FordPrfkt/KT88-Amp/boards/Bias/Bias.png

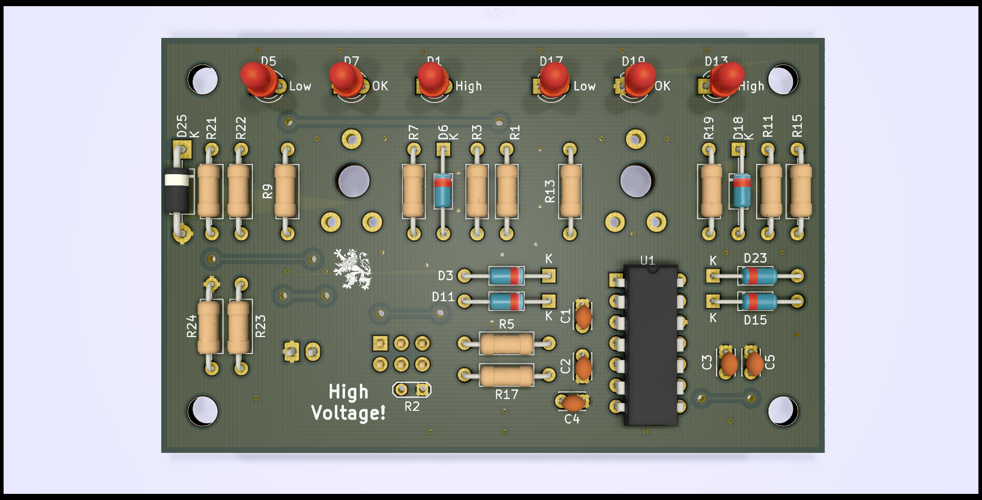
boards/Bias/Bias.png
