FordPrfkt/KT88-Amp/boards/Netzteil/400V_Anoden/400VAnoden.png

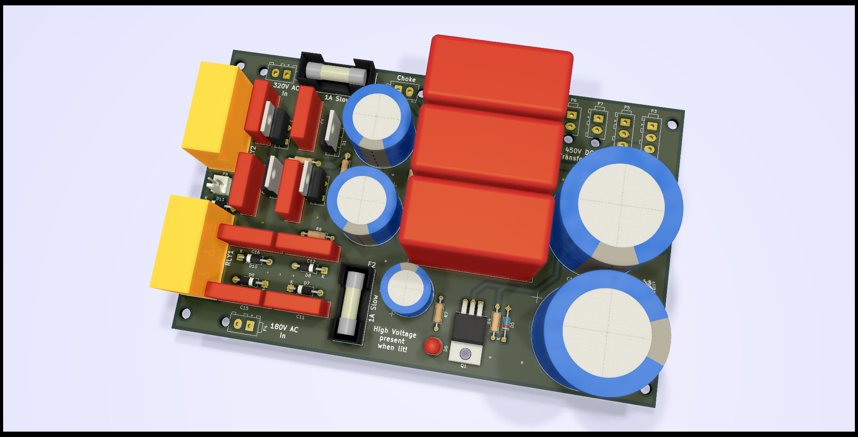
boards/Netzteil/400V_Anoden/400VAnoden.png
