FordPrfkt/KT88-Amp/README.md

# KT88-Amp
Tube Amplifier using KT88 Tubes
