FordPrfkt/KT88-Amp/boards/Endstufe/Endstufe.png

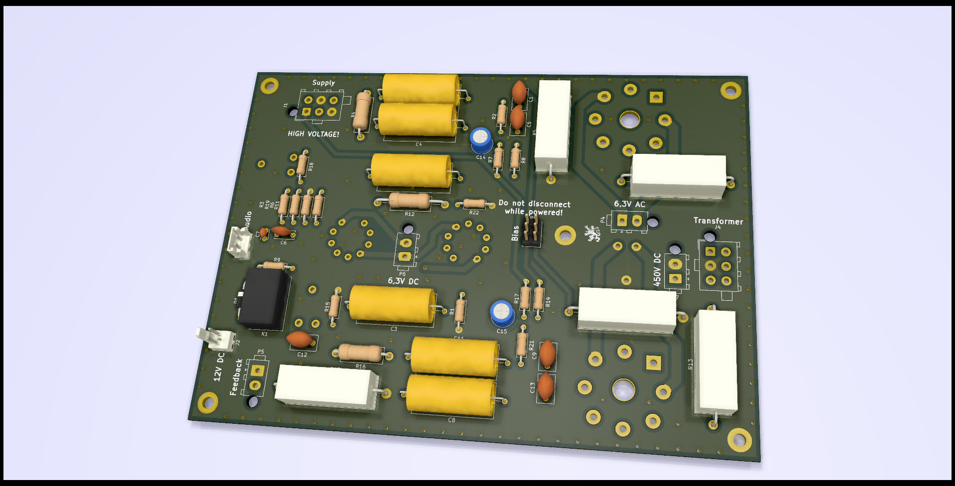
boards/Endstufe/Endstufe.png
