FordPrfkt/KT88-Amp/boards/Netzteil/Anoden_Stabi/Anoden_Stabi.png

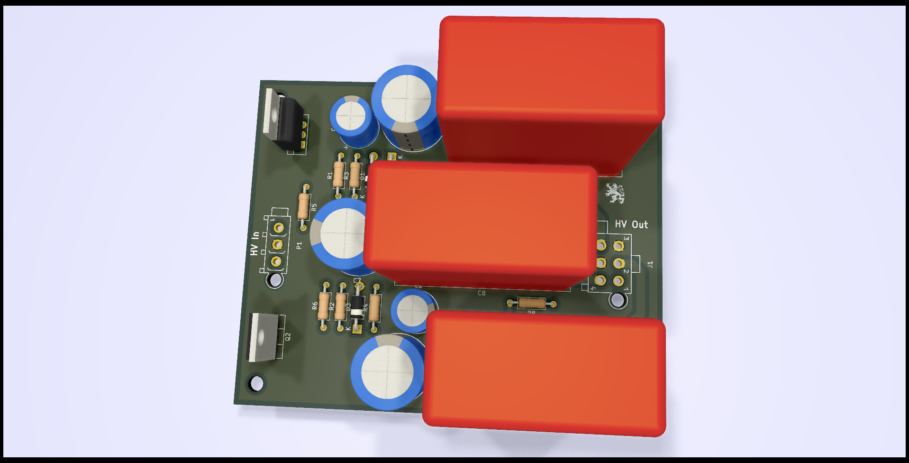
boards/Netzteil/Anoden_Stabi/Anoden_Stabi.png
