FordPrfkt/KT88-Amp/Boards/ReglerV2/Regler.step

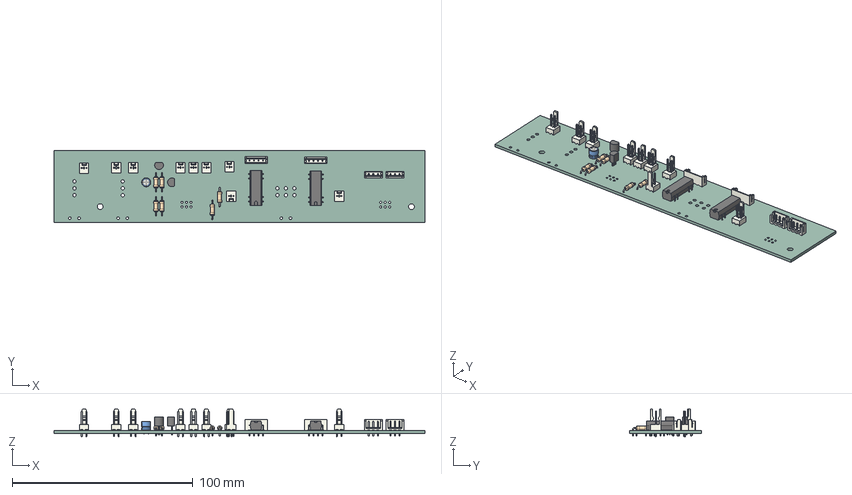
[picture p5: CAD file, 2025-02-26]
Boards/ReglerV2/Regler.step
205.0 x 40.0 x 15.3 mm
Relay_StandexMeder_DIP_LowProfile x 2
JST_B4B_EH_A x 2
JST_B3B_EH_A x 2
Molex_AE_6410_02A x 9
R_Axial_DIN0207_L63mm_D25mm_P1016mm_Horizontal x 6
TO-92_Inline_Narrow x 2
CP_Radial_D50mm_P250mm
_autosave-Regler_PCB
