FordPrfkt/KT88-Amp/boards/Netzteil/12V_6V3_Delay/12V_6V3_Delay.pdf

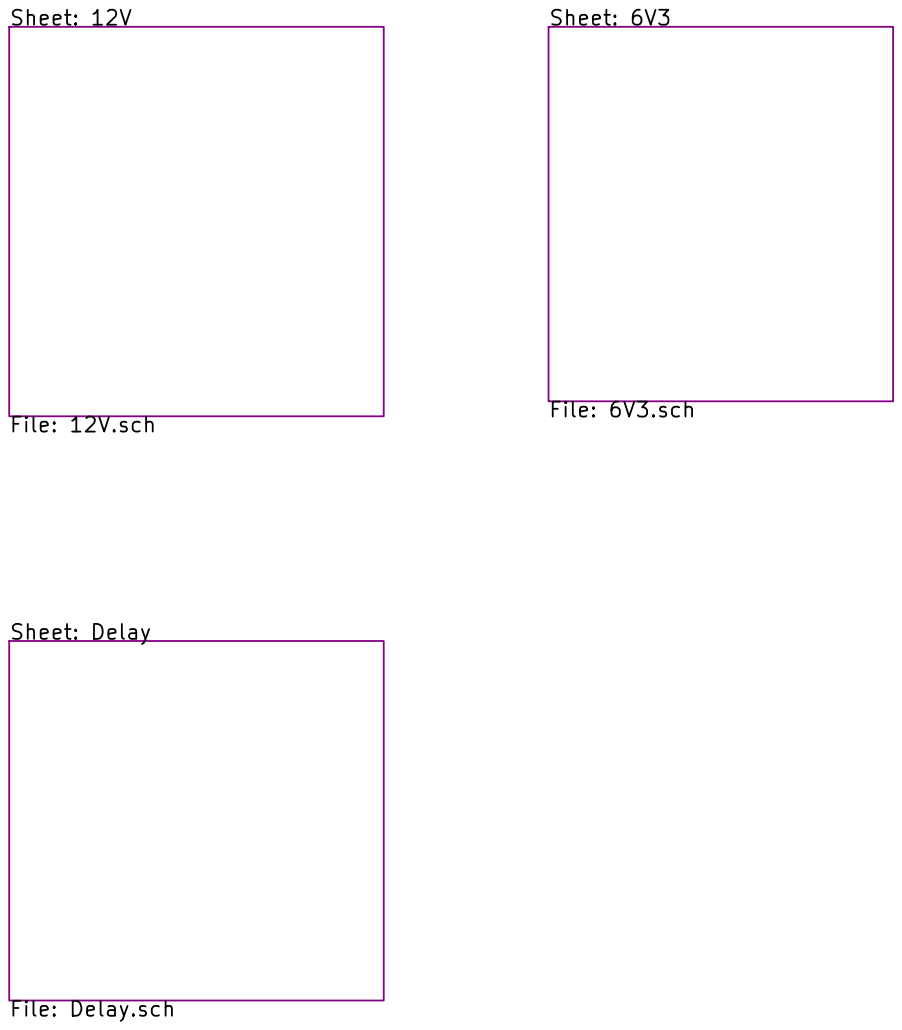
[picture p6: page 1]

fordprfkt@googlemail.com
File: 12V_6V3_Delay.sch Sheet: / Daniel Walter

Id: 1/4 Title: KT88 12V, 6,3V DC Regler & Einschaltverzögerung

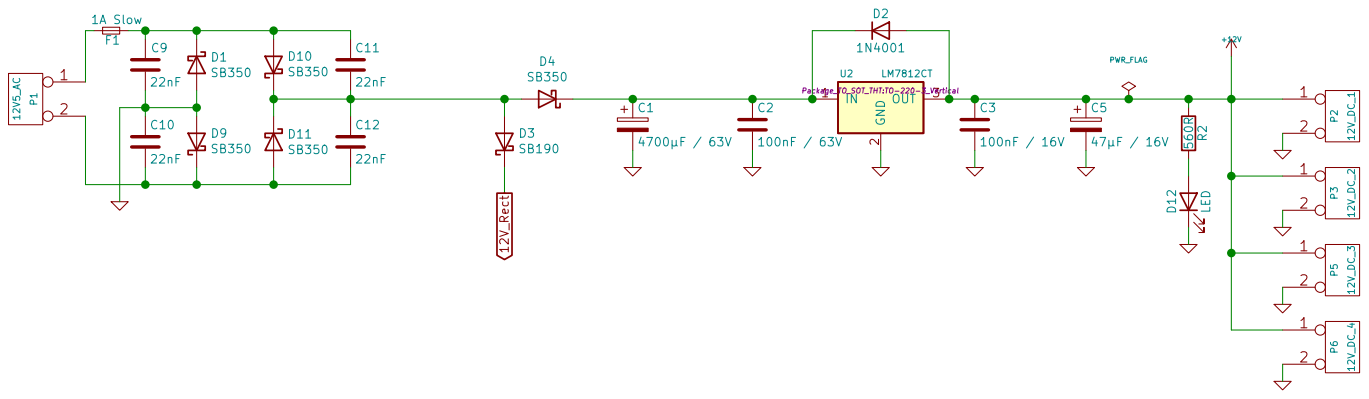
[picture p7: page 2]

12V Spannungsregler
fordprfkt@googlemail.com
File: 12V.sch Sheet: /12V/ Daniel Walter

Id: 2/4 Title: KT88 12V, 6,3V DC Regler & Einschaltverzögerung

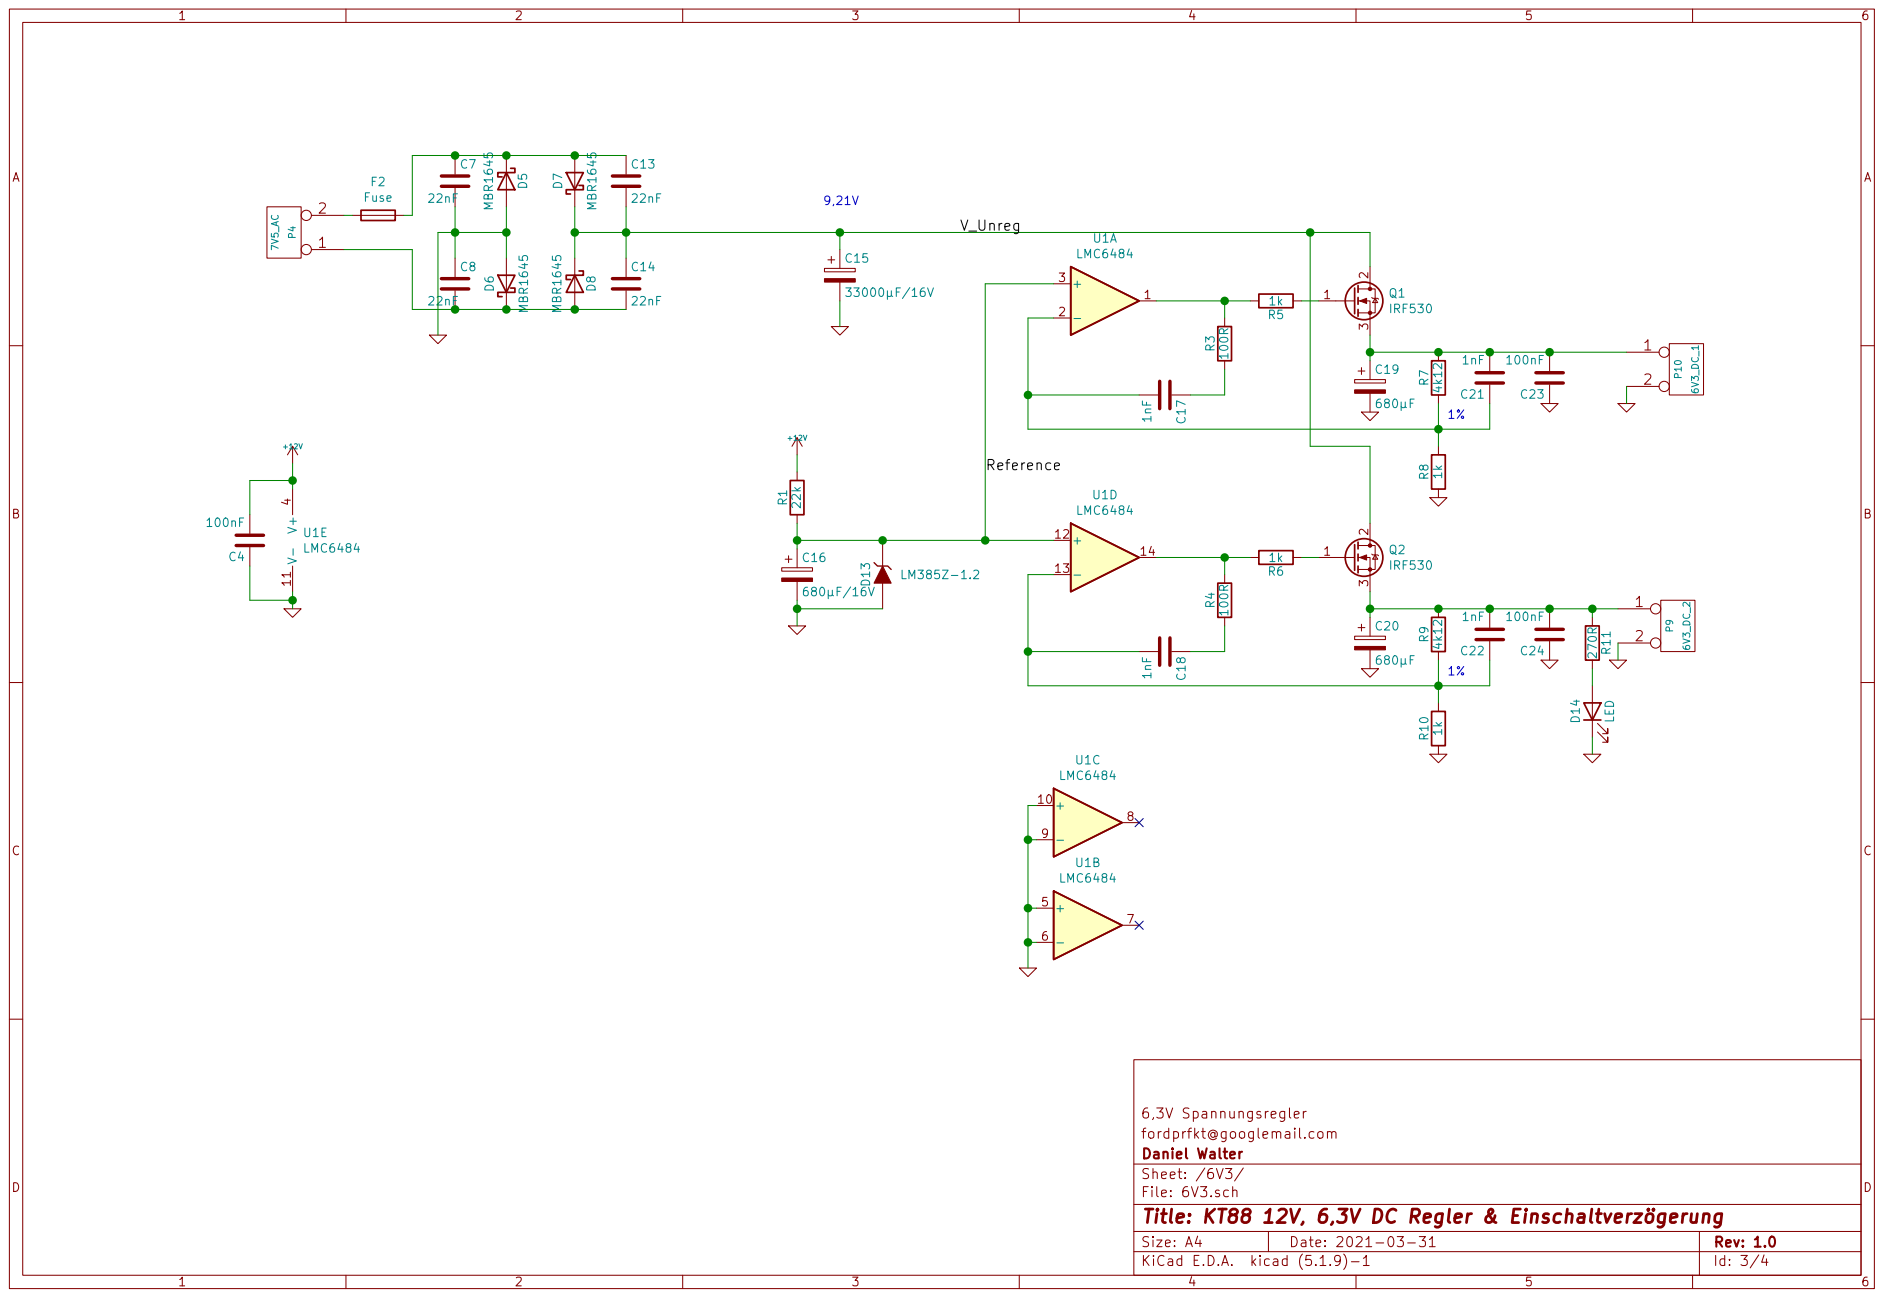
[picture p8: page 3]

6,3V Spannungsregler
fordprfkt@googlemail.com
File: 6V3.sch Sheet: /6V3/ Daniel Walter

Id: 3/4 Title: KT88 12V, 6,3V DC Regler & Einschaltverzögerung

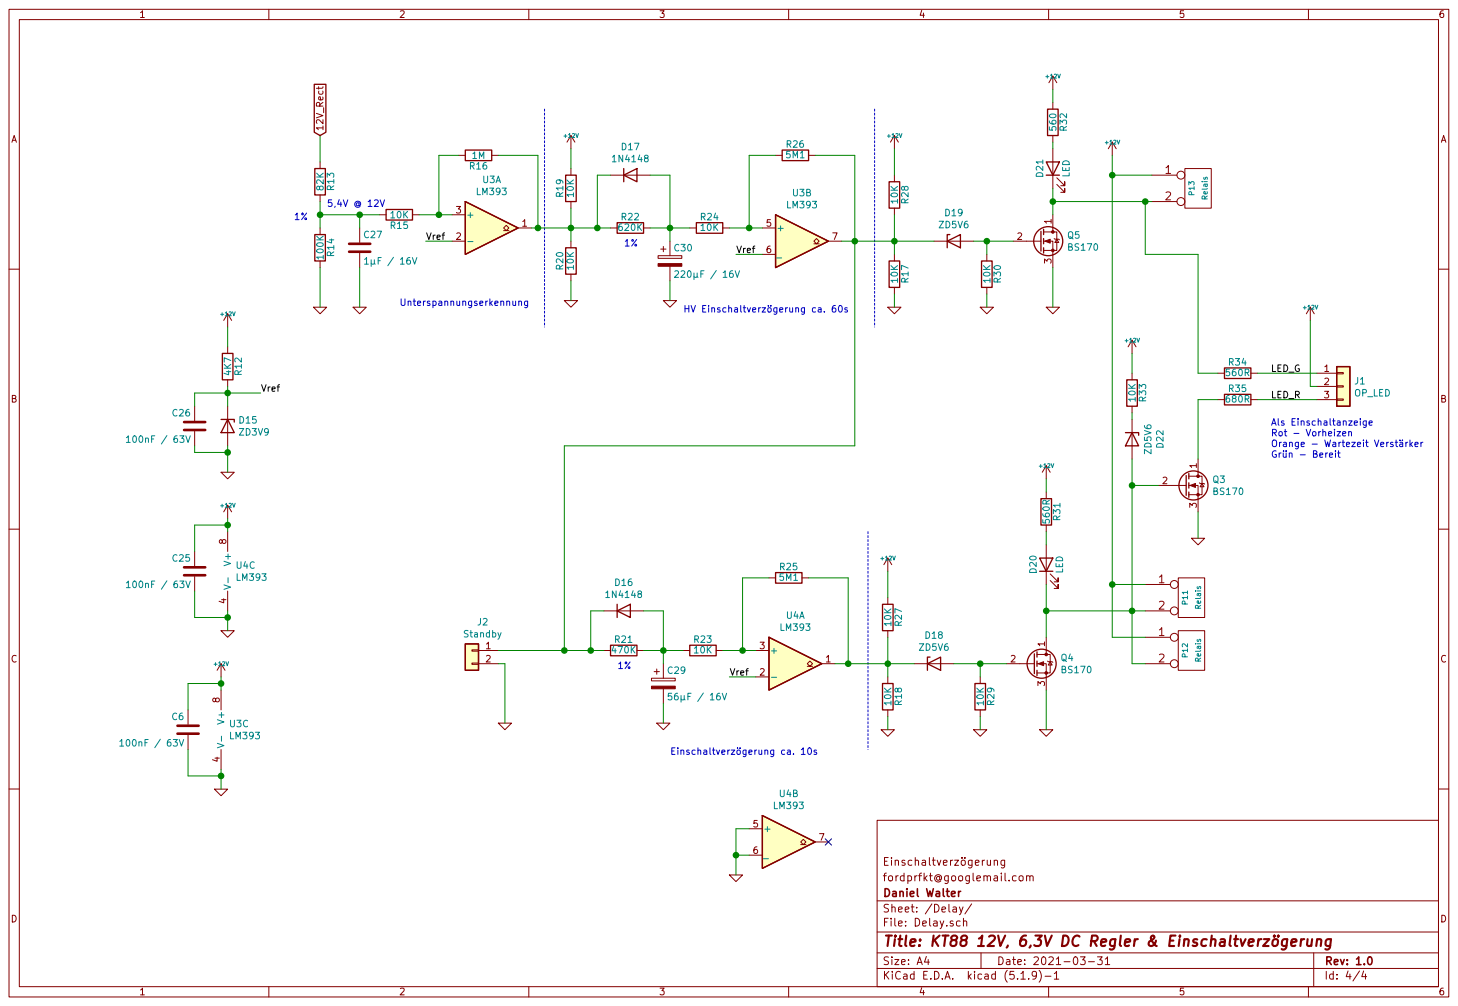
[picture p9: page 4]

Als Einschaltanzeige Rot - Vorheizen Orange - Wartezeit Verstärker Grün - Bereit HV Einschaltverzögerung ca. 60s

Einschaltverzögerung
fordprfkt@googlemail.com
Sheet: /Delay/ Daniel Walter

File: Delay.sch
Id: 4/4 Title: KT88 12V, 6,3V DC Regler & Einschaltverzögerung
