FordPrfkt/KT88-Amp/Boards/ReglerV2/Draft2.asc

C1: cap; 1µ
D1: diode; 1N4148
L1: ind; 3.5mH; Rser=580
M1: nmos; BSS145
Q2: pnp; BC327-25
R1: res; 470k
R2: res; 560
R3: res; 100
R4: res; 1Meg
V1: voltage; PULSE(0 12 0 0.00001 0.00001 0.5 1 3)
V2: voltage; 12; Rser=0
Named nets: 0
.tran 4
