FordPrfkt/KT88-Amp/Boards/Netzteil/12V_6V3_Delay/Delay.asc

C1: polcap; 1µ; V=50 Irms=6.2m Rser=2.66795 Lser=851.833p mfg="Würth Elektronik" pn="865230640005 WCAP-AS5H 4x5,5" type="Al electrolytic"
C2: polcap; 330µ; V=16 Irms=235m Rser=0.36 Lser=0
C4: polcap; 10µ; V=25 Irms=235m Rser=0.46 Lser=0
D1: zener; 1N748
D2: diode; 1N4148
D3: zener; ZD5V6
D4: LED; NSCW100
D5: diode; 1N4148
D6: zener; ZD5V6
D7: LED; NSCW100
M1: nmos; BS170
M2: nmos; BS170
R1: res; 82K; tol=1 pwr=0.1
R2: res; 100k
R3: res; 10k
R4: res; 1Meg; tol=1 pwr=0.1
R5: res; 10K; tol=1 pwr=0.1
R6: res; 10K; tol=1 pwr=0.1
R7: res; 220K; tol=1 pwr=0.1
R8: res; 10K; tol=1 pwr=0.1
R9: res; 5Meg1; tol=1 pwr=0.1
R10: res; 10K; tol=1 pwr=0.1
R11: res; 100K; tol=1 pwr=0.1
R13: res; 562; tol=1 pwr=0.1
R14: res; 4.75K; tol=1 pwr=0.1
R15: res; 330K; tol=1 pwr=0.1
R16: res; 10K; tol=1 pwr=0.1
R17: res; 5Meg1; tol=1 pwr=0.25
R19: res; 10K; tol=1 pwr=0.1
R20: res; 100K; tol=1 pwr=0.1
R21: res; 562; tol=1 pwr=0.1
S1: sw; MYSW
U1: LM2903B
U2: LM2903B
U3: LM2903B
V1: voltage; PULSE(0 12 65 0 0 2)
V2: voltage; 12; Rser=0.01
Named nets: 0, VRef, VSup
.model BS170 VDMOS VTO=1.824 RG=270 RS=1.572 RD=1.436 RB=.768 KP=.1233 Cgdmax=20p Cgdmin=3p CGS=28p Cjo=35p Rds=1.2E8 IS=5p Bv=60 Ibv=10u Tt=161.6n
.model 1N748 D(Is=1.252f Rs=1.156 Ikf=0 N=1 Xti=3 Eg=1.11 Cjo=205p M=.6004 Vj=.75 Fc=.5 Isr=1.867n Nr=2 Bv=3.9 Ibv=17.244m Nbv=2.4016 Ibvl=8.619m Nbvl=13.283 Tbv1=-384.62u Vpk=3.9 mfg=Motorola type=zener)
.model ZD5V6 D(Is=1.252f Rs=1.156 Ikf=0 N=1 Xti=3 Eg=1.11 Cjo=205p M=.6004 Vj=.75 Fc=.5 Isr=1.867n Nr=2 Bv=5.6 Ibv=17.244m Nbv=2.4016 Ibvl=8.619m Nbvl=13.283 Tbv1=-384.62u Vpk=5.6 mfg=Motorola type=zener)
.tran 0 70 0 startup
.model MYSW SW(Ron=0.01 Roff=1Meg Vt=10 Vh=-.4)
