FordPrfkt/KT88-Amp/Boards/Netzteil/Anoden_Stabi/Anoden_Stabi.kicad_pcb

## KiCad design Boards/Netzteil/Anoden_Stabi/Anoden_Stabi.kicad_pcb (2025-02-26)

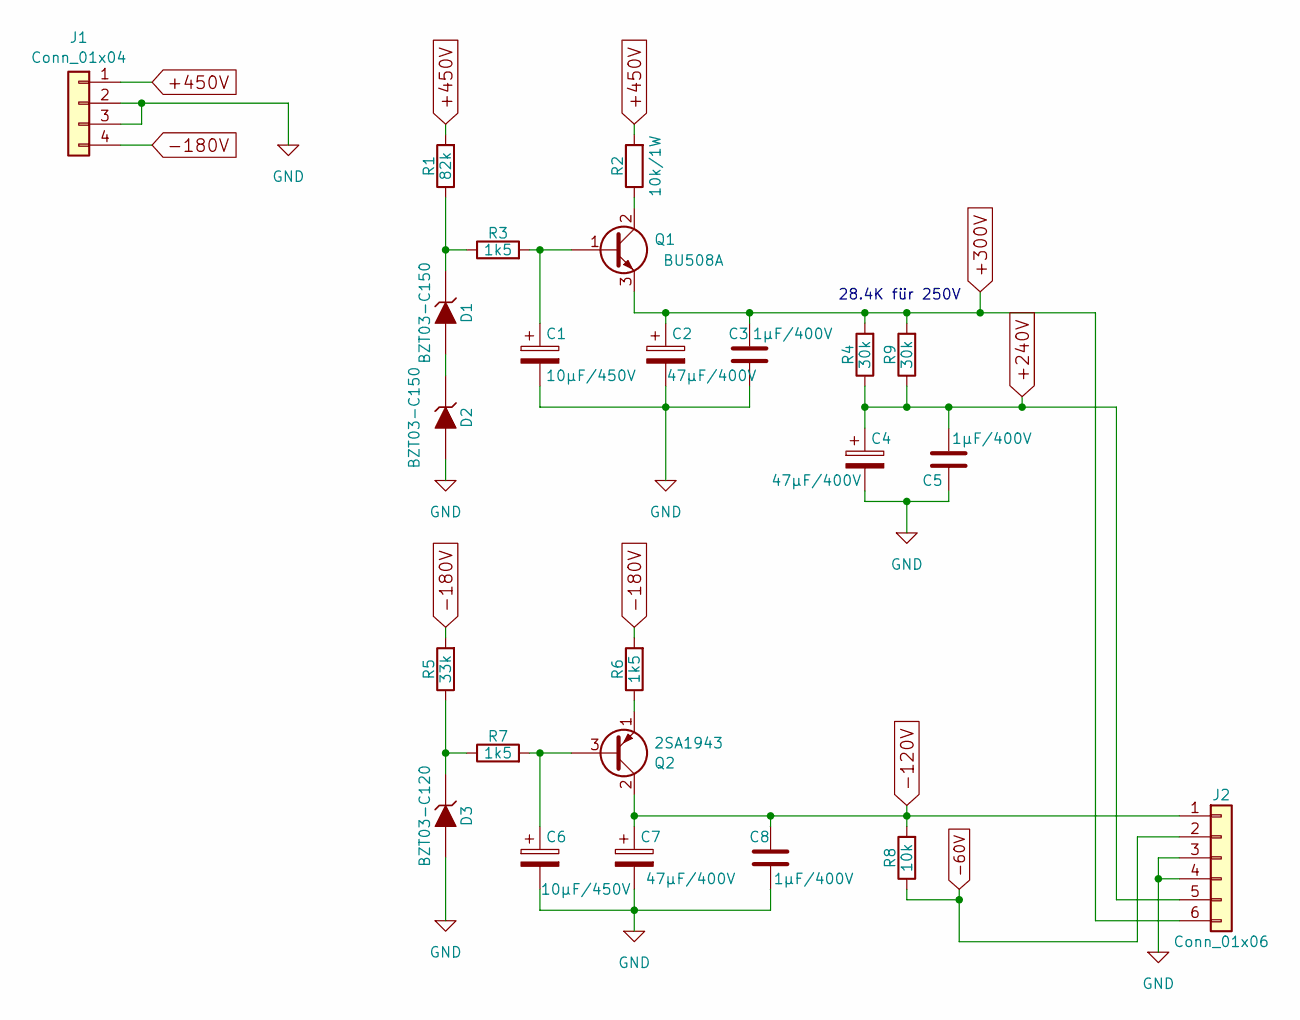
[picture p10: schematic Anoden_Stabi.kicad_sch]

Parts:
C1, C6: 10µF/450V; CP_Radial_D12.5mm_P5.00mm
C2, C4, C7: 47µF/400V; CP_Radial_D17.0mm_P7.50mm
C3, C5, C8: 1µF/400V; C_Rect_L31.5mm_W11.0mm_P27.50mm_MKS4
D1, D2: BZT03-C150; D_DO-41_SOD81_P10.16mm_Horizontal
D3: BZT03-C120; D_DO-41_SOD81_P10.16mm_Horizontal
J1: Conn_01x04; Molex_Mini-Fit_Jr_5566-04A_2x02_P4.20mm_Vertical
J2: Conn_01x06; Molex_Mini-Fit_Jr_5566-06A_2x03_P4.20mm_Vertical
Q1: BU508A; TO-3P-3_Vertical
Q2: 2SA1943; TO-3P-3_Vertical
R1: 82k; R_Axial_DIN0207_L6.3mm_D2.5mm_P10.16mm_Horizontal
R2: 10k/1W; R_Axial_DIN0414_L11.9mm_D4.5mm_P15.24mm_Horizontal
R3, R6, R7: 1k5; R_Axial_DIN0414_L11.9mm_D4.5mm_P15.24mm_Horizontal
R4, R9: 30k; R_Axial_DIN0207_L6.3mm_D2.5mm_P10.16mm_Horizontal
R5: 33k; R_Axial_DIN0207_L6.3mm_D2.5mm_P10.16mm_Horizontal
R8: 10k; R_Axial_DIN0414_L11.9mm_D4.5mm_P15.24mm_Horizontal

Connections:
+240V: C4.1, C5.2, J2.5, R4.1, R9.1
+300V: C2.1, C3.2, J2.6, Q1.3 (E), R4.2, R9.2
+450V: J1.1, R1.2, R2.2
-60V: J2.2, R8.1
-120V: C7.1, C8.2, J2.1, Q2.2 (C), R8.2
-180V: J1.4, R5.2, R6.2
GND: C1.2, C2.2, C3.1, C4.2, C5.1, C6.2, C7.2, C8.1, D2.2 (A), D3.2 (A), J1.2, J1.3, J2.3, J2.4
unnamed: D1.2 (A), D2.1 (K)
unnamed: D1.1 (K), R1.1, R3.1
unnamed: D3.1 (K), R5.1, R7.1
unnamed: C1.1, Q1.1 (B), R3.2
unnamed: Q1.2 (C), R2.1
unnamed: C6.1, Q2.3 (B), R7.2
unnamed: Q2.1 (E), R6.1

Notes on the sheet:
28.4K für 250V

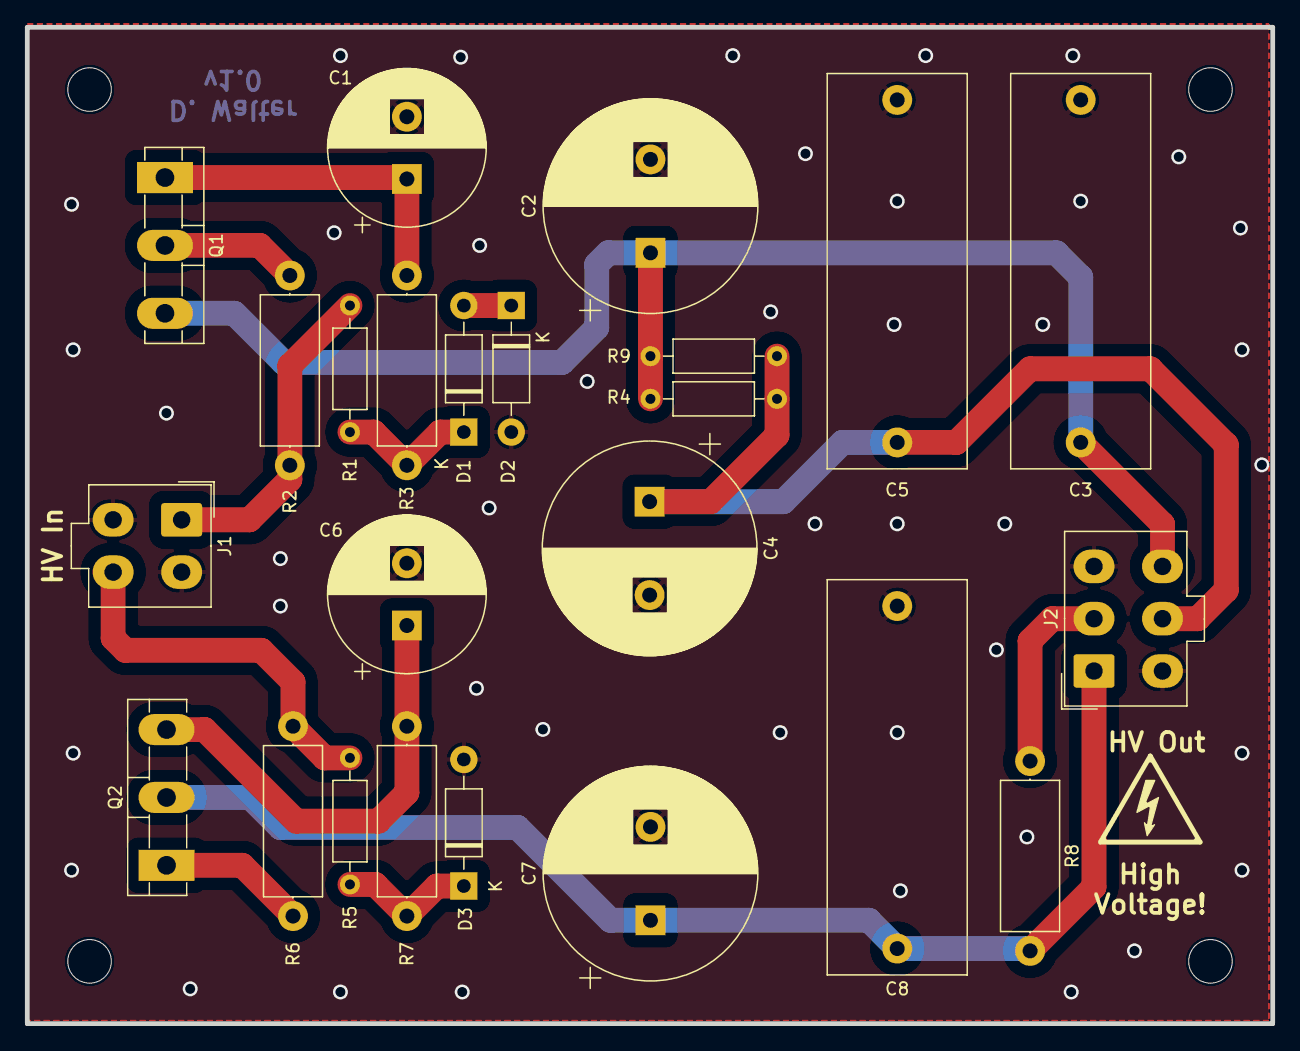
[picture p11: board Anoden_Stabi.kicad_pcb from above]

Board: 2 copper layers, 100.0 x 80.0 mm, 24 parts (0 on the bottom side), 14 nets.
