FordPrfkt/KT88-Amp/Boards/Endstufe/Endstufe.kicad_pcb

## KiCad design Boards/Endstufe/Endstufe.kicad_pcb (2025-02-26)

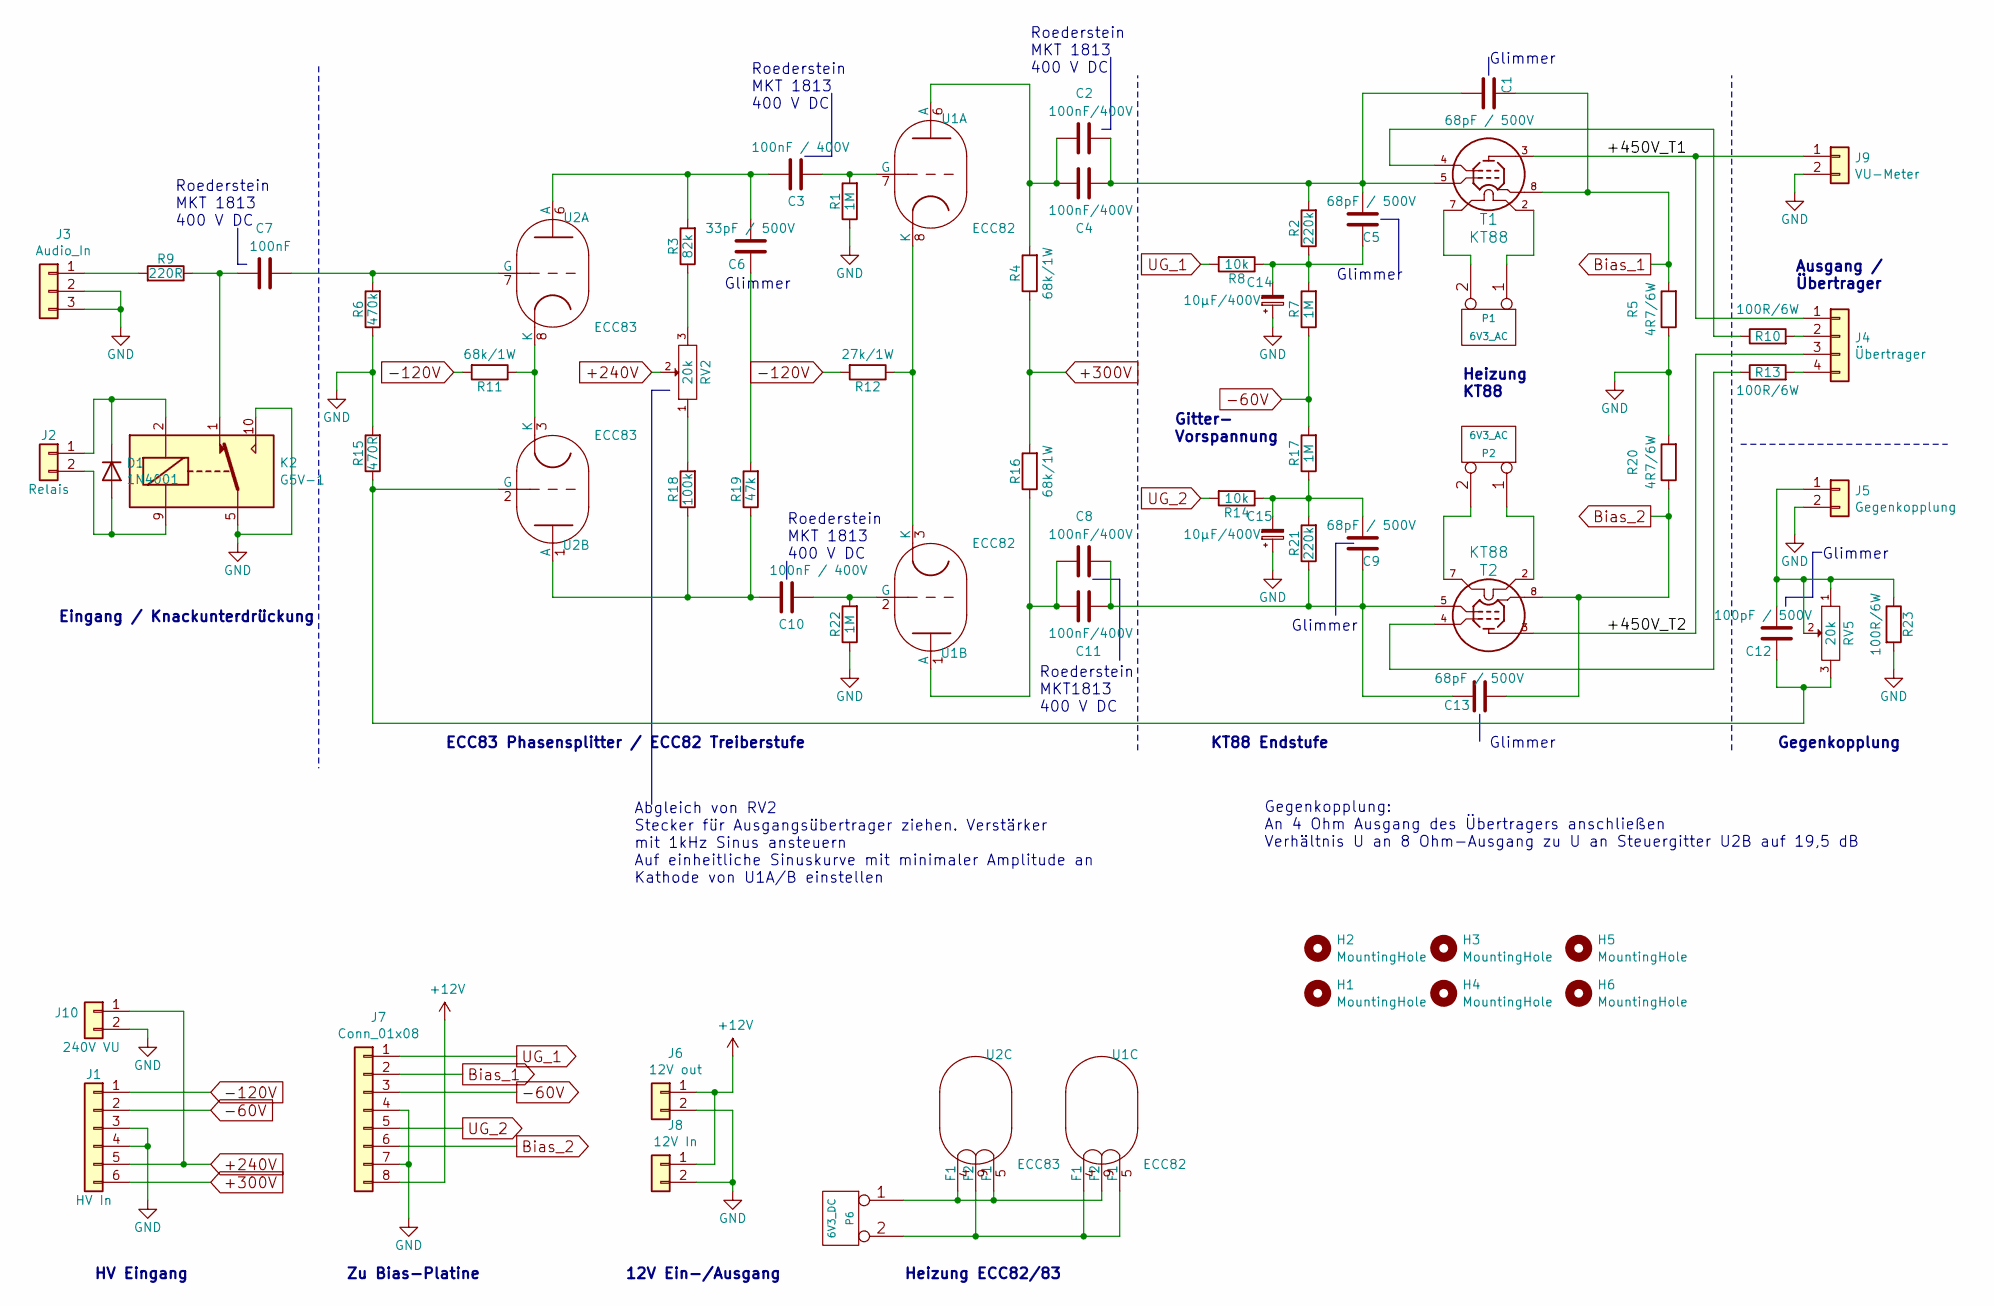
[picture p12: schematic Endstufe.kicad_sch, KT88 Endstufe]

Parts:
C1, C5, C9, C13: 68pF / 500V; C_Disc_D11.0mm_W5.0mm_P7.50mm
C2, C4, C8, C11: 100nF/400V; C_Axial_L19.0mm_D7.5mm_P25.00mm_Horizontal
C3, C10: 100nF / 400V; C_Axial_L19.0mm_D7.5mm_P25.00mm_Horizontal
C6: 33pF / 500V; C_Disc_D11.0mm_W5.0mm_P7.50mm
C7: 100nF; C_Axial_L19.0mm_D7.5mm_P25.00mm_Horizontal
C12: 100pF / 500V; C_Disc_D11.0mm_W5.0mm_P7.50mm
C14, C15: 10µF/400V; CP_Radial_D12.5mm_P5.00mm
D1: 1N4001; D_DO-41_SOD81_P10.16mm_Horizontal
H1, H2, H3, H4, H5, H6: MountingHole; MountingHole_3.2mm_M3
J1: HV In; Molex_Mini-Fit_Jr_5566-06A_2x03_P4.20mm_Vertical
J2: Relais; Molex_KK-254_AE-6410-02A_1x02_P2.54mm_Vertical
J3: Audio_In; JST_EH_B3B-EH-A_1x03_P2.50mm_Vertical
J4: Übertrager; Molex_Mini-Fit_Jr_5566-04A_2x02_P4.20mm_Vertical
J5: Gegenkopplung; Molex_Mini-Fit_Jr_5566-02A_2x01_P4.20mm_Vertical
J6: 12V out; Molex_KK-254_AE-6410-02A_1x02_P2.54mm_Vertical
J7: Conn_01x08; IDC-Header_2x04_P2.54mm_Vertical
J8: 12V In; Molex_KK-254_AE-6410-02A_1x02_P2.54mm_Vertical
J9: VU-Meter; Molex_Mini-Fit_Jr_5566-02A_2x01_P4.20mm_Vertical
J10: 240V VU; Molex_Mini-Fit_Jr_5566-02A_2x01_P4.20mm_Vertical
K2: G5V-1; Relay_SPDT_Omron_G5V-1
P1, P2: 6V3_AC; Molex_Mini-Fit_Jr_5566-02A_2x01_P4.20mm_Vertical
P6: 6V3_DC; Molex_Mini-Fit_Jr_5566-02A_2x01_P4.20mm_Vertical
R1, R7, R17, R22: 1M; R_Axial_DIN0207_L6.3mm_D2.5mm_P10.16mm_Horizontal
R2, R21: 220k; R_Axial_DIN0207_L6.3mm_D2.5mm_P10.16mm_Horizontal
R3: 82k; R_Axial_DIN0207_L6.3mm_D2.5mm_P10.16mm_Horizontal
R4, R16: 68k/1W; R_Axial_DIN0207_L6.3mm_D2.5mm_P10.16mm_Horizontal
R5, R20: 4R7/6W; R_Axial_DIN0922_L20.0mm_D9.0mm_P25.40mm_Horizontal
R6: 470k; R_Axial_DIN0207_L6.3mm_D2.5mm_P10.16mm_Horizontal
R8, R14: 10k; R_Axial_DIN0207_L6.3mm_D2.5mm_P10.16mm_Horizontal
R9: 220R; R_Axial_DIN0207_L6.3mm_D2.5mm_P10.16mm_Horizontal
R10, R13, R23: 100R/6W; R_Axial_DIN0922_L20.0mm_D9.0mm_P25.40mm_Horizontal
R11: 68k/1W; R_Axial_DIN0207_L6.3mm_D2.5mm_P15.24mm_Horizontal
R12: 27k/1W; R_Axial_DIN0207_L6.3mm_D2.5mm_P15.24mm_Horizontal
R15: 470R; R_Axial_DIN0207_L6.3mm_D2.5mm_P10.16mm_Horizontal
R18: 100k; R_Axial_DIN0207_L6.3mm_D2.5mm_P10.16mm_Horizontal
R19: 47k; R_Axial_DIN0207_L6.3mm_D2.5mm_P10.16mm_Horizontal
RV2, RV5: 20k; Potentiometer_Vishay_T7-YA_Single_Vertical
T1, T2: KT88; Valve_Octal
U1: ECC82; Valve_ECC-83-1
U2: ECC83; Valve_ECC-83-1

Connections:
+12V: J6.1, J7.8, J8.1
+240V: J1.5, J10.1, RV2.2
+300V: J1.6, R4.1, R16.2
-60V: J1.2, J7.3, R7.1, R17.2
-120V: J1.1, R11.2, R12.2
/+450V_T1: J4.1, J9.1, T1.3 (a)
/+450V_T2: J4.3, T2.3 (a)
Bias_1: C1.1, J7.2, R5.2, T1.8 (k)
Bias_2: C13.2, J7.6, R20.1, T2.8 (k)
GND: C14.1, C15.1, J1.3, J1.4, J3.2, J3.3, J5.2, J6.2, J7.4, J7.7, J8.2, J9.2, J10.2, K2.5, K2.6, K2.10, R1.1, R5.1, R6.1, R15.2, R20.2, R22.1, R23.2
unnamed: C6.1, R19.2
unnamed: C7.1, K2.1, R9.1
unnamed: C5.1, C14.2, R2.1, R7.2, R8.1
unnamed: C9.2, C15.2, R14.1, R17.1, R21.2
unnamed: D1.2 (A), J2.2, K2.9
unnamed: D1.1 (K), J2.1, K2.2
unnamed: J3.1, R9.2
unnamed: J4.2, R10.2
unnamed: J4.4, R13.2
unnamed: C12.2, J5.1, R23.1, RV5.1, RV5.2
unnamed: P1.1, T1.2 (f)
unnamed: P1.2, T1.7 (f)
unnamed: P2.1, T2.2 (f)
unnamed: P2.2, T2.7 (f)
unnamed: P6.1, U1.9 (F2), U2.4 (F1), U2.5 (F1)
unnamed: P6.2, U1.4 (F1), U1.5 (F1), U2.9 (F2)
unnamed: R3.1, RV2.3
unnamed: R18.2, RV2.1
unnamed: C1.2, C2.1, C4.1, C5.2, R2.2, T1.5 (g1)
unnamed: R10.1, T1.4 (g2)
unnamed: C8.1, C9.1, C11.1, C13.1, R21.1, T2.5 (g1)
unnamed: R13.1, T2.4 (g2)
unnamed: C2.2, C4.2, R4.2, U1.6 (A)
unnamed: C3.1, R1.2, U1.7 (G)
unnamed: R12.1, U1.3 (K), U1.8 (K)
unnamed: C8.2, C11.2, R16.1, U1.1 (A)
unnamed: C10.1, R22.2, U1.2 (G)
unnamed: C3.2, C6.2, R3.2, U2.6 (A)
unnamed: C7.2, R6.2, U2.7 (G)
unnamed: R11.1, U2.3 (K), U2.8 (K)
unnamed: C10.2, R18.1, R19.1, U2.1 (A)
unnamed: C12.1, R15.1, RV5.3, U2.2 (G)
UG_1: J7.1, R8.2
UG_2: J7.5, R14.2

Notes on the sheet:
Glimmer
Heizung ECC82/83
Gitter- Vorspannung
Abgleich von RV2 Stecker für Ausgangsübertrager ziehen. Verstärker mit 1kHz Sinus ansteuern Auf einheitliche Sinuskurve mit minimaler Amplitude an Kathode von U1A/B einstellen
HV Eingang
Ausgang / Übertrager
Eingang / Knackunterdrückung
12V Ein-/Ausgang
Gegenkopplung: An 4 Ohm Ausgang des Übertragers anschließen Verhältnis U an 8 Ohm-Ausgang zu U an Steuergitter U2B auf 19,5 dB
Roederstein MKT 1813 400 V DC
Zu Bias-Platine
Gegenkopplung
ECC83 Phasensplitter / ECC82 Treiberstufe
KT88 Endstufe
Roederstein MKT1813 400 V DC
Roederstein MKT 1813 400 V DC
Heizung KT88

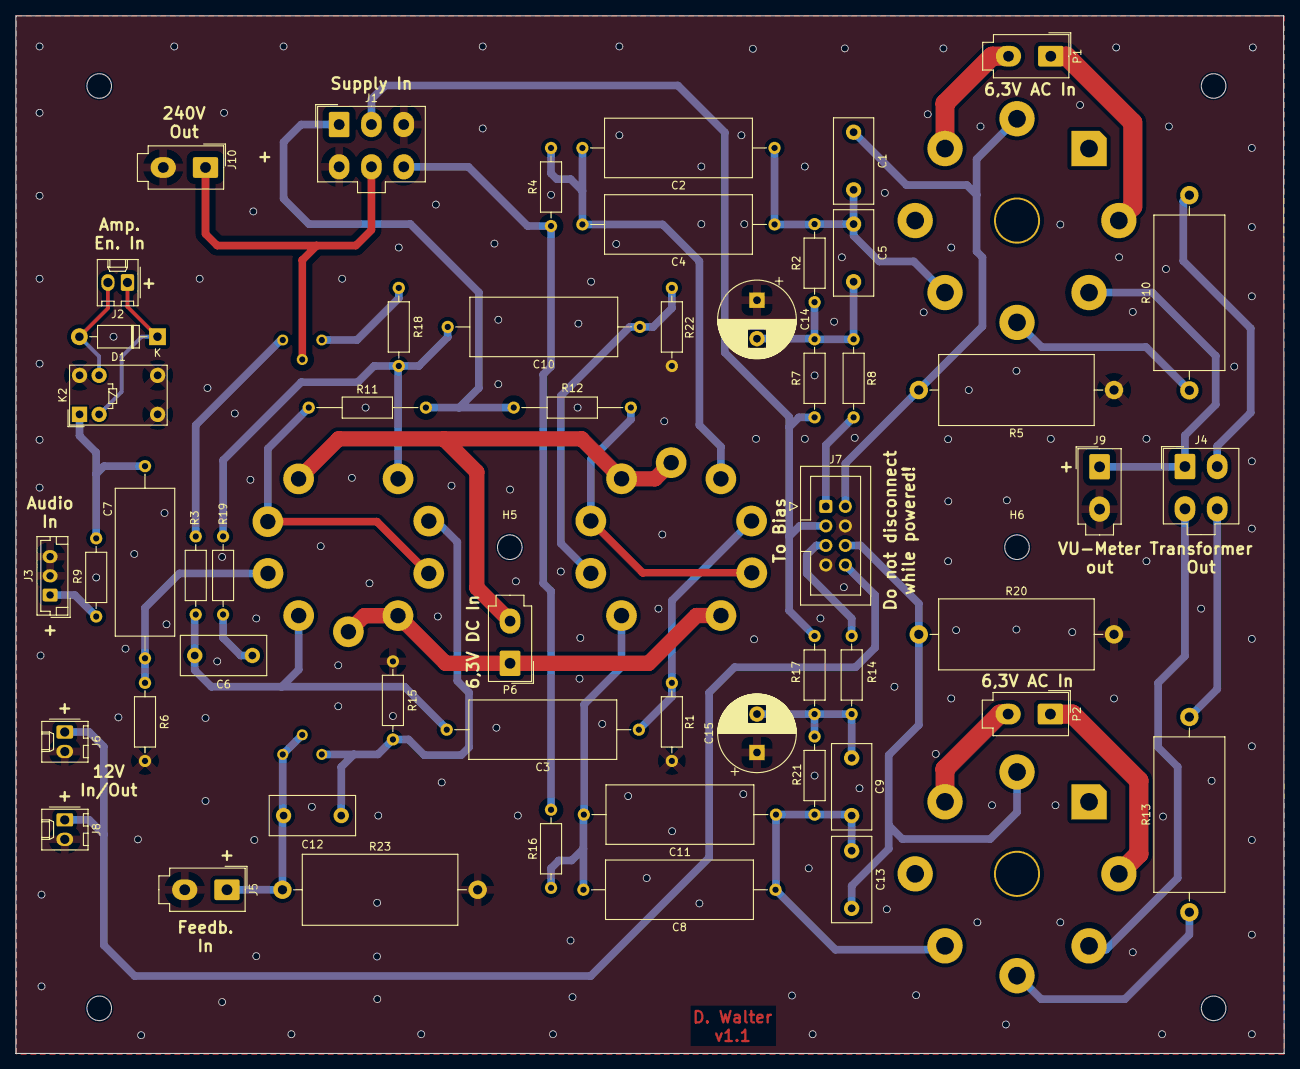
[picture p13: board Endstufe.kicad_pcb from above]

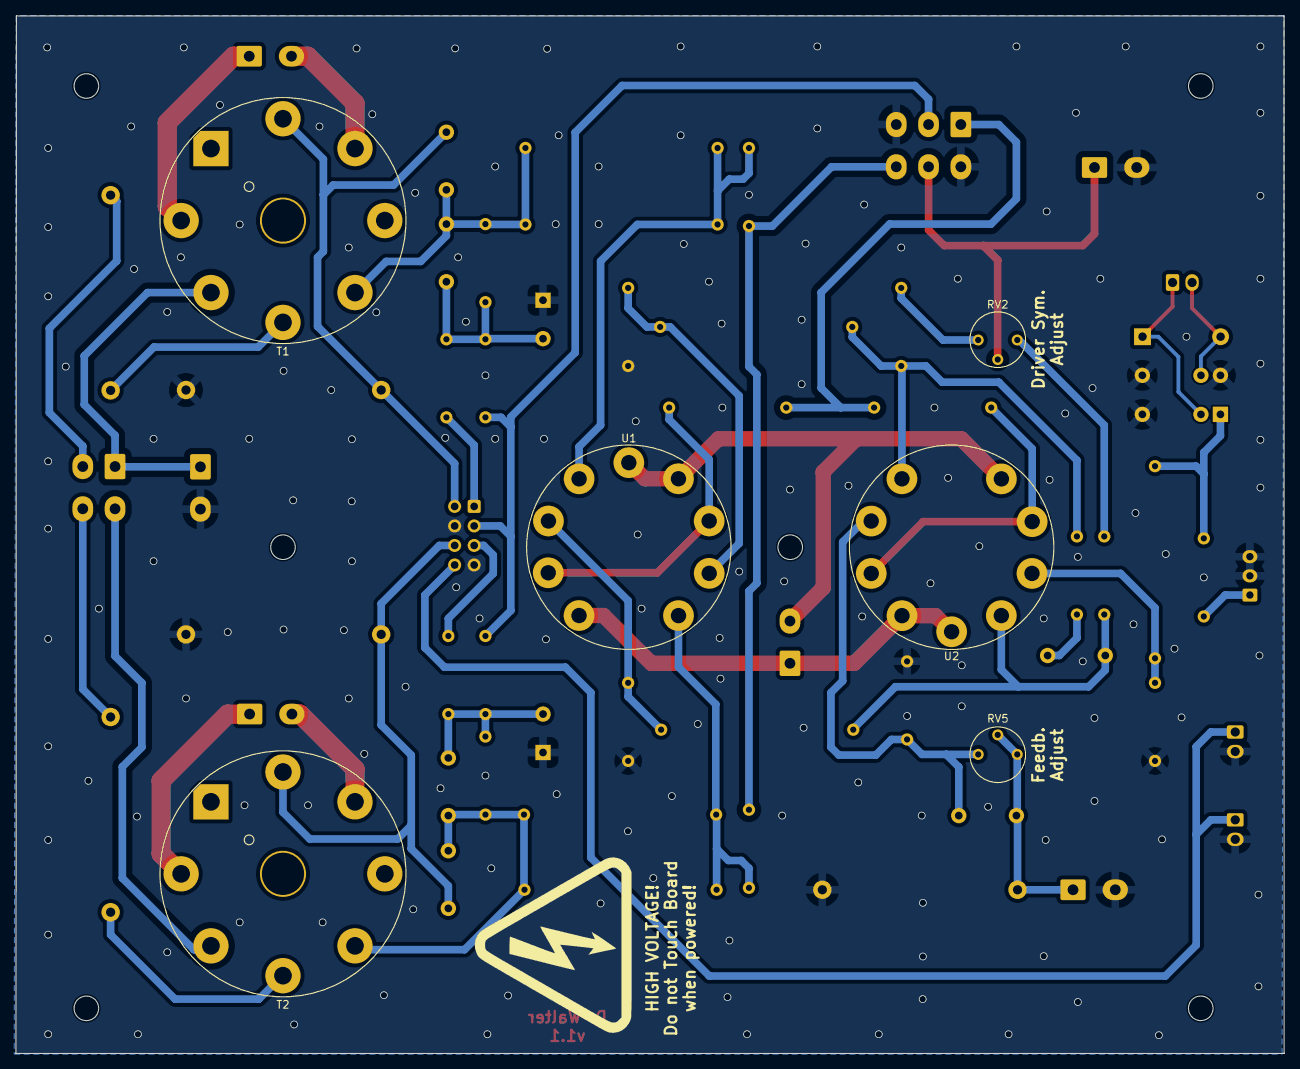
[picture p14: board Endstufe.kicad_pcb from below]

Board: 2 copper layers, 165.0 x 135.0 mm, 65 parts (6 on the bottom side), 44 nets.
