FordPrfkt/KT88-Amp/Boards/Bias/Bias.kicad_pcb

## KiCad design Boards/Bias/Bias.kicad_pcb (2025-02-26)

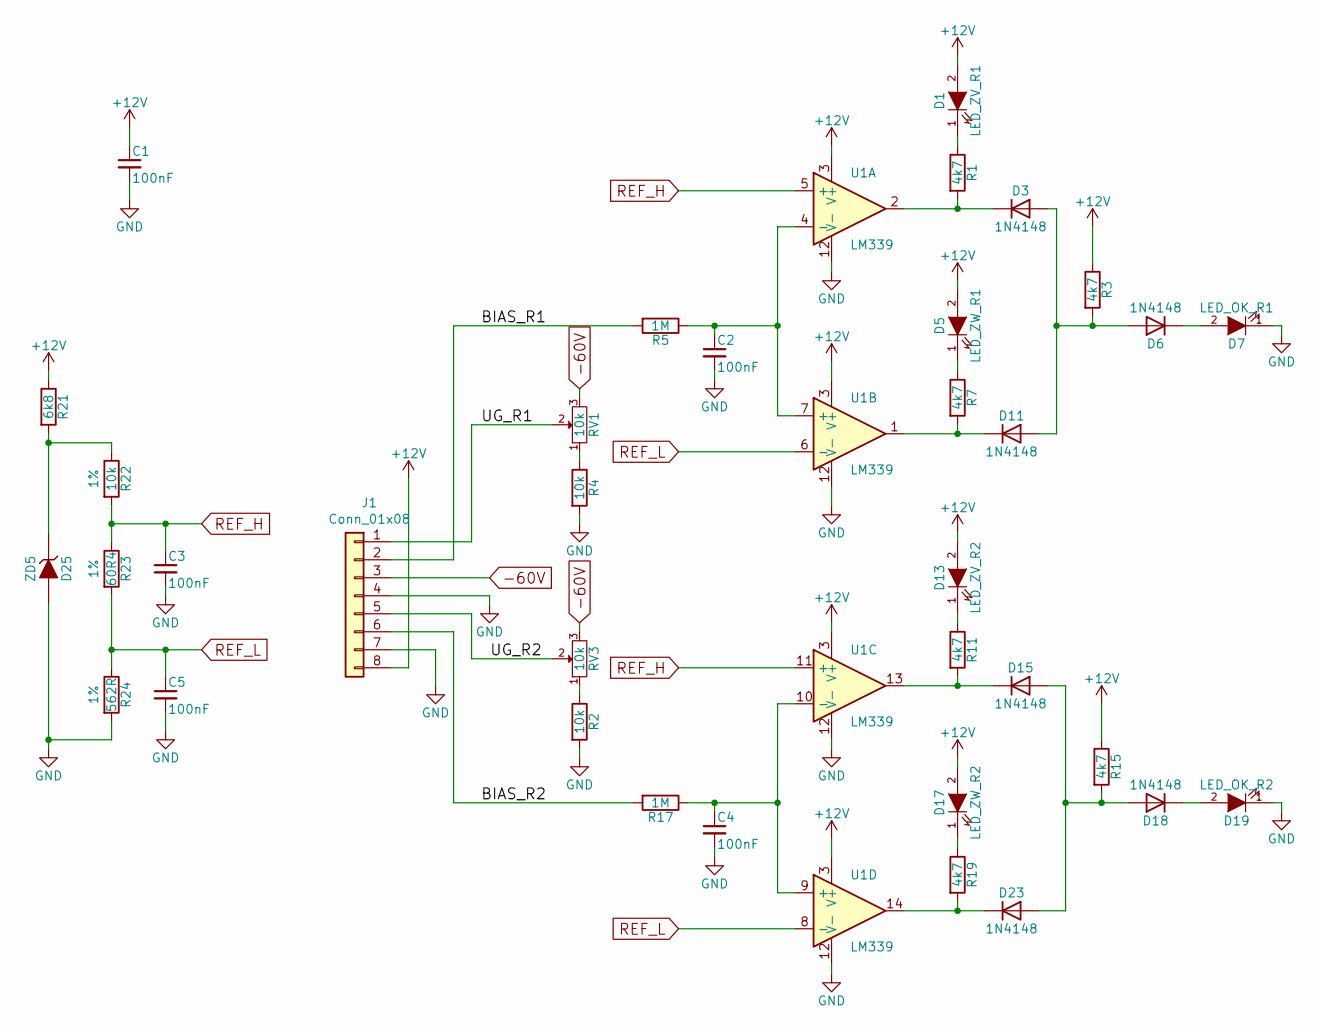
[picture p15: schematic Bias.kicad_sch, KT88 Bias Board]

Parts:
C1, C2, C3, C4, C5: 100nF; C_Disc_D4.3mm_W1.9mm_P5.00mm
D1: LED_ZV_R1; LED_D3.0mm
D3, D6, D11, D15, D18, D23: 1N4148; D_DO-35_SOD27_P10.16mm_Horizontal
D5: LED_ZW_R1; LED_D3.0mm
D7: LED_OK_R1; LED_D3.0mm
D13: LED_ZV_R2; LED_D3.0mm
D17: LED_ZW_R2; LED_D3.0mm
D19: LED_OK_R2; LED_D3.0mm
D25: ZD5; D_DO-41_SOD81_P10.16mm_Horizontal
J1: Conn_01x08; IDC-Header_2x04_P2.54mm_Vertical
R1, R3, R7, R11, R15, R19: 4k7; R_Axial_DIN0207_L6.3mm_D2.5mm_P10.16mm_Horizontal
R2, R4: 10k; R_Axial_DIN0207_L6.3mm_D2.5mm_P10.16mm_Horizontal
R5, R17: 1M; R_Axial_DIN0207_L6.3mm_D2.5mm_P10.16mm_Horizontal
R21: 6k8; R_Axial_DIN0207_L6.3mm_D2.5mm_P10.16mm_Horizontal
R22: 10k; R_Axial_DIN0207_L6.3mm_D2.5mm_P10.16mm_Horizontal; Tolerance 1%
R23: 60R4; R_Axial_DIN0207_L6.3mm_D2.5mm_P10.16mm_Horizontal; Tolerance 1%
R24: 562R; R_Axial_DIN0207_L6.3mm_D2.5mm_P10.16mm_Horizontal; Tolerance 1%
RV1, RV3: 10k; Potentiometer_Piher_PT-10-V10_Vertical_Hole
U1: LM339; DIP-14_W7.62mm

Connections:
+12V: C1.1, D1.2 (A), D5.2 (A), D13.2 (A), D17.2 (A), J1.8, R3.1, R15.1, R21.1, U1.3 (V+)
-60V: J1.3, RV1.3, RV3.3
/BIAS_R1: J1.2, R5.2
/BIAS_R2: J1.6, R17.2
/UG_R1: J1.1, RV1.2
/UG_R2: J1.5, RV3.2
GND: C1.2, C2.2, C3.2, C4.2, C5.2, D7.1 (K), D19.1 (K), D25.2 (A), J1.4, J1.7, R2.2, R4.2, R24.2, U1.12 (V-)
unnamed: D1.1 (K), R1.1
unnamed: D3.1 (K), R1.2, U1.2
unnamed: D5.1 (K), R7.1
unnamed: D6.1 (K), D7.2 (A)
unnamed: D3.2 (A), D6.2 (A), D11.2 (A), R3.2
unnamed: D11.1 (K), R7.2, U1.1
unnamed: D13.1 (K), R11.1
unnamed: D15.2 (A), D18.2 (A), D23.2 (A), R15.2
unnamed: D15.1 (K), R11.2, U1.13
unnamed: D17.1 (K), R19.1
unnamed: D18.1 (K), D19.2 (A)
unnamed: D23.1 (K), R19.2, U1.14
unnamed: D25.1 (K), R21.2, R22.1
unnamed: R2.1, RV3.1
unnamed: R4.1, RV1.1
unnamed: C2.1, R5.1, U1.4 (-), U1.7 (+)
unnamed: C4.1, R17.1, U1.9 (+), U1.10 (-)
REF_H: C3.1, R22.2, R23.1, U1.5 (+), U1.11 (+)
REF_L: C5.1, R23.2, R24.1, U1.6 (-), U1.8 (-)

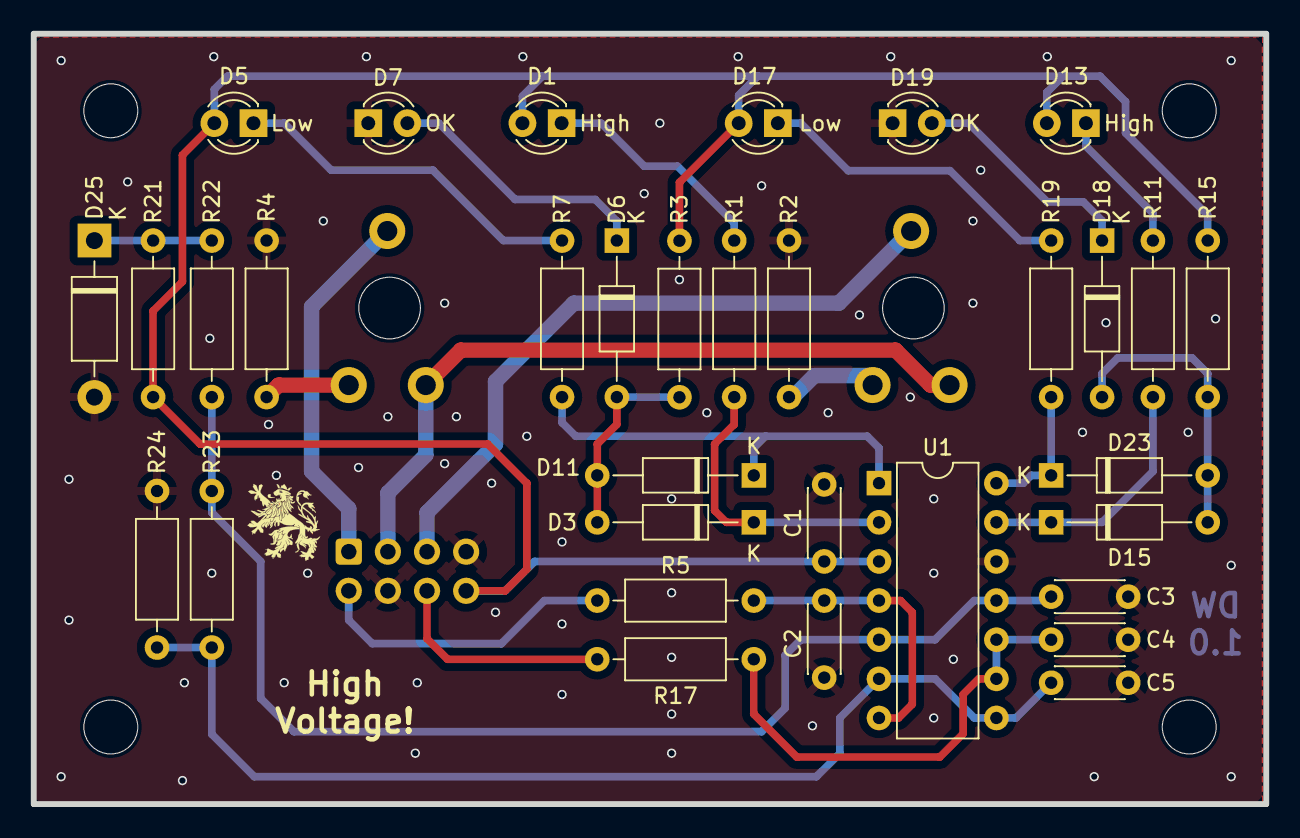
[picture p16: board Bias.kicad_pcb from above]

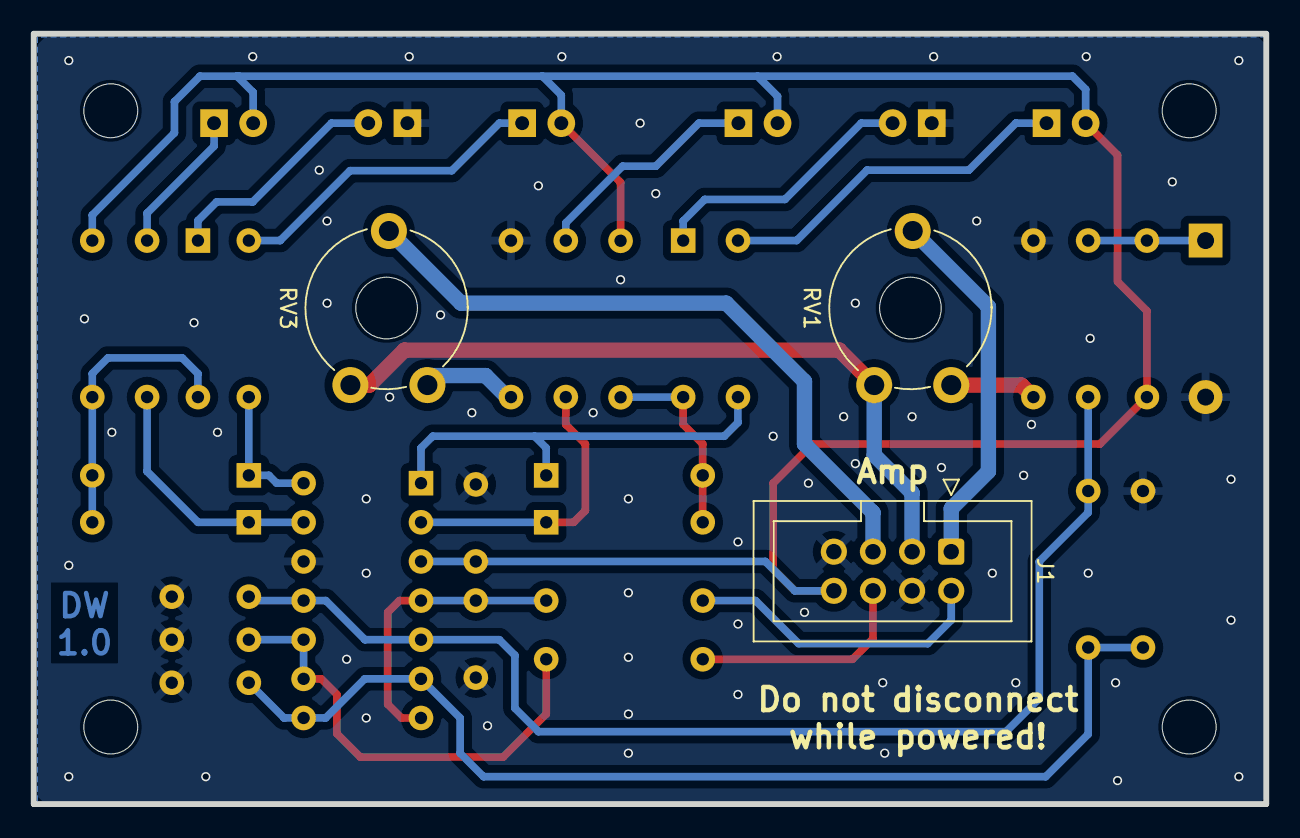
[picture p17: board Bias.kicad_pcb from below]

Board: 2 copper layers, 80.0 x 50.0 mm, 36 parts (3 on the bottom side), 26 nets.
