FordPrfkt/KT88-Amp/boards/Eingang/Eingang.kicad_pcb

## KiCad design boards/Eingang/Eingang.kicad_pcb (2024-11-20)

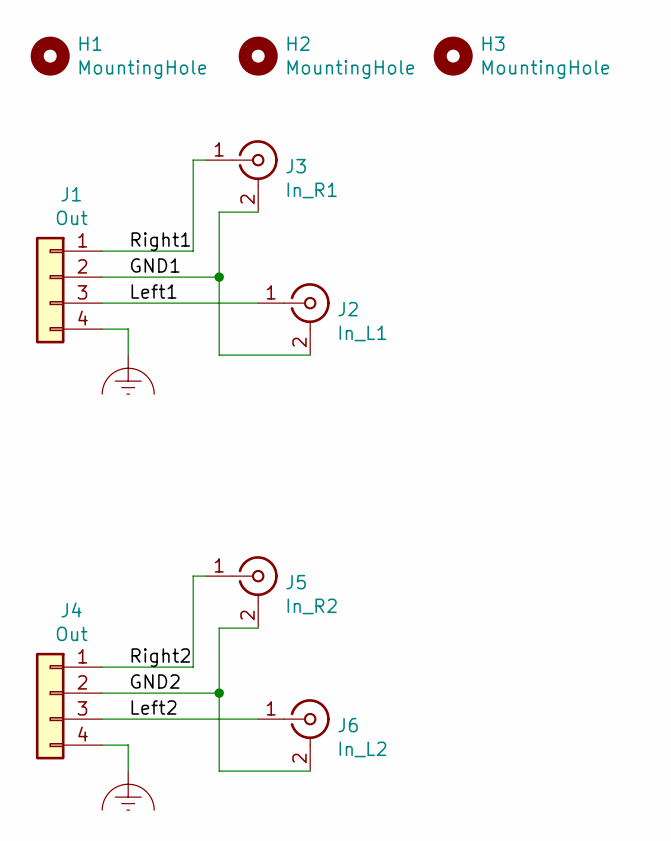
[picture p18: schematic Eingang.kicad_sch]

Parts:
H1, H2, H3: MountingHole; MountingHole_3.2mm_M3
J1, J4: Out; JST_EH_B4B-EH-A_1x04_P2.50mm_Vertical
J2: In_L1; BTOR1
J3: In_R1; BTOR1
J5: In_R2; BTOR1
J6: In_L2; BTOR1

Connections:
/GND1: J1.2, J2.2 (Ext), J3.2 (Ext)
/GND2: J4.2, J5.2 (Ext), J6.2 (Ext)
/Left1: J1.3, J2.1 (In)
/Left2: J4.3, J6.1 (In)
/Right1: J1.1, J3.1 (In)
/Right2: J4.1, J5.1 (In)
Earth_Clean: J1.4, J4.4

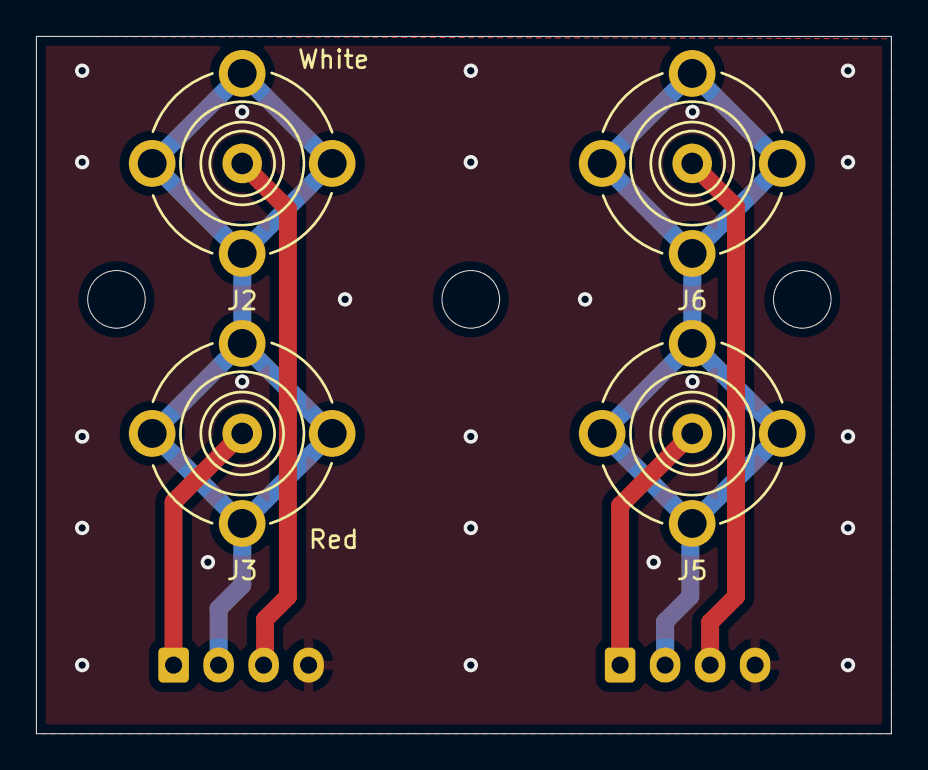
[picture p19: board Eingang.kicad_pcb from above]

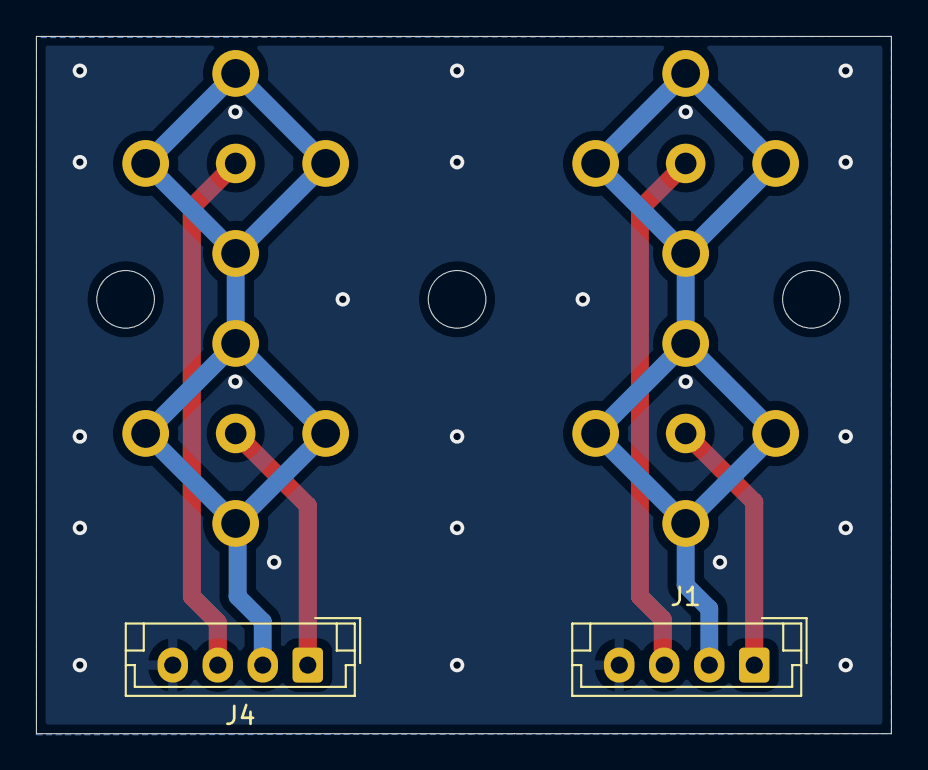
[picture p20: board Eingang.kicad_pcb from below]

Board: 2 copper layers, 47.5 x 38.7 mm, 9 parts (2 on the bottom side), 7 nets.
