FordPrfkt/KT88-Amp/boards/NoLoad_Protection/Protection/Protection.kicad_pcb

## KiCad design boards/NoLoad_Protection/Protection/Protection.kicad_pcb (2024-11-20)

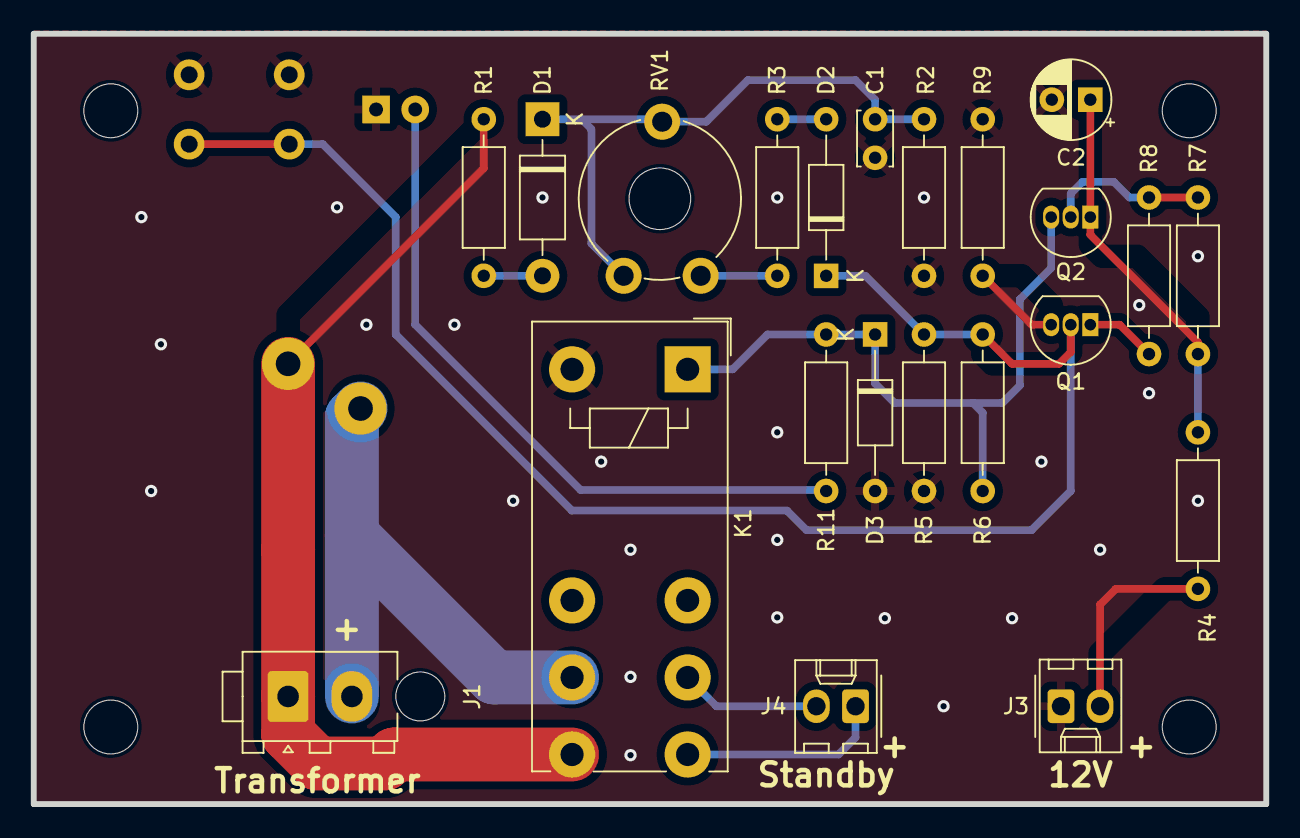
[picture p21: board Protection.kicad_pcb from above]

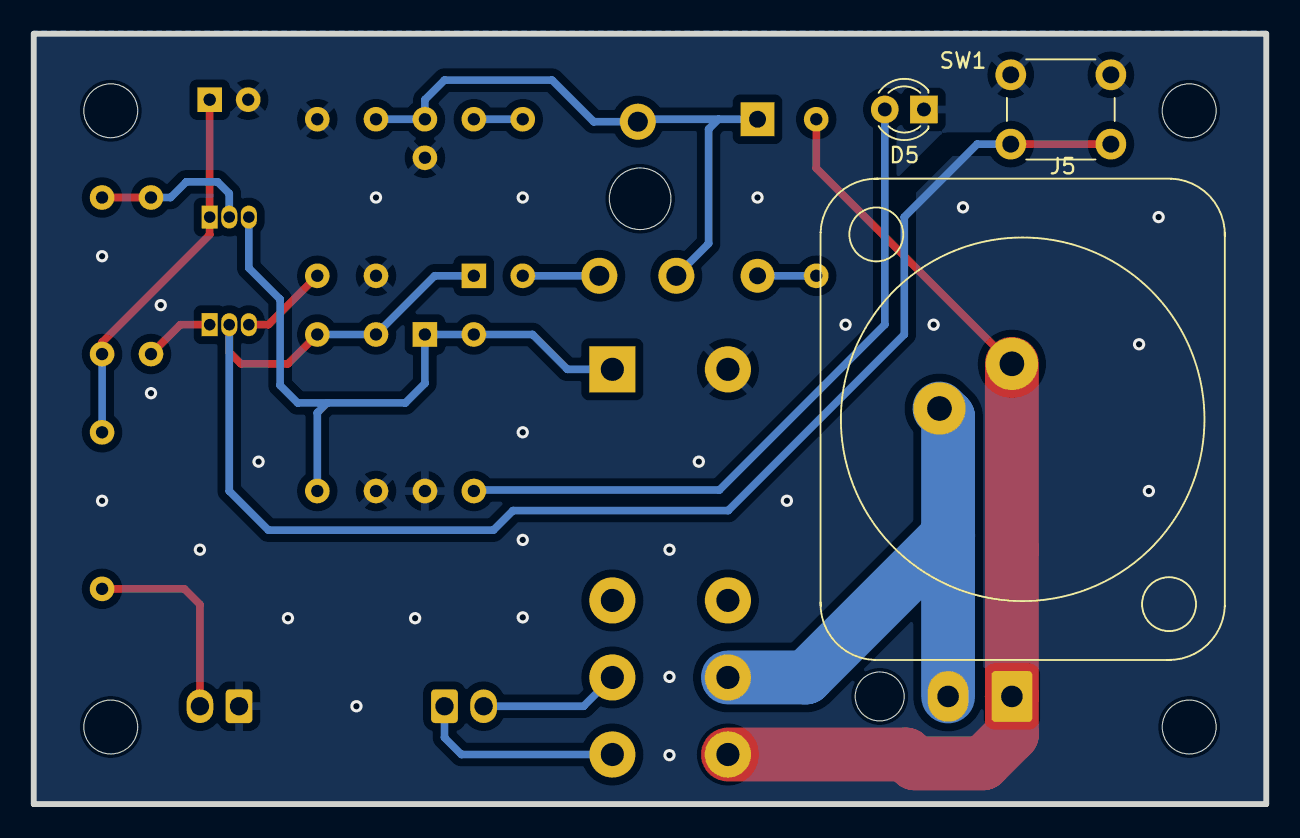
[picture p22: board Protection.kicad_pcb from below]

Board: 2 copper layers, 80.0 x 50.0 mm, 25 parts (3 on the bottom side), 17 nets.

Parts:
C1: 47nF; C_Disc_D3.4mm_W2.1mm_P2.50mm
C2: 47µF; CP_Radial_D5.0mm_P2.50mm
D1: 1N4007; D_DO-41_SOD81_P10.16mm_Horizontal
D2, D3: 1N4148; D_DO-35_SOD27_P10.16mm_Horizontal
D5: LED; LED_D3.0mm
J1: Transformer; TE_MATE-N-LOK_1-770866-x_1x02_P4.14mm_Vertical
J3: 12V_In; Molex_KK-254_AE-6410-02A_1x02_P2.54mm_Vertical
J4: Standby; Molex_KK-254_AE-6410-02A_1x02_P2.54mm_Vertical
J5: Speaker; Jack_speakON_Neutrik_NL2MD-V_Vertical
K1: FINDER-40.52; Relay_DPDT_Finder_40.52
Q1: BC546; TO-92_Inline
Q2: BC327; TO-92_Inline
R1: 1k5; R_Axial_DIN0207_L6.3mm_D2.5mm_P10.16mm_Horizontal
R2: 47k; R_Axial_DIN0207_L6.3mm_D2.5mm_P10.16mm_Horizontal
R3: 10k; R_Axial_DIN0207_L6.3mm_D2.5mm_P10.16mm_Horizontal
R4: 10R; R_Axial_DIN0207_L6.3mm_D2.5mm_P10.16mm_Horizontal
R5: 3k3; R_Axial_DIN0207_L6.3mm_D2.5mm_P10.16mm_Horizontal
R6: 33k; R_Axial_DIN0207_L6.3mm_D2.5mm_P10.16mm_Horizontal
R7: 1k; R_Axial_DIN0207_L6.3mm_D2.5mm_P10.16mm_Horizontal
R8: 4k7; R_Axial_DIN0207_L6.3mm_D2.5mm_P10.16mm_Horizontal
R9: 100R; R_Axial_DIN0207_L6.3mm_D2.5mm_P10.16mm_Horizontal
R11: R; R_Axial_DIN0207_L6.3mm_D2.5mm_P10.16mm_Horizontal
RV1: 250k; Potentiometer_Piher_PT-10-V10_Vertical_Hole
SW1: Reset; SW_PUSH_6mm_H7.3mm

Connections:
+12V: J3.2, R4.2
/Standby: J4.1, K1.14
GND: C1.2, C2.2, D3.2 (A), D5.1 (K), J3.1, K1.A2, R2.1, R5.1, R9.1, SW1.1
unnamed: D1.2 (A), R1.1
unnamed: C1.1, D1.1 (K), R2.2, RV1.2, RV1.3
unnamed: D2.2 (A), R3.1
unnamed: D2.1 (K), Q1.2 (B), R5.2, R6.2, SW1.2
unnamed: D3.1 (K), K1.A1, Q2.3 (E), R6.1, R11.2
unnamed: D5.2 (A), R11.1
unnamed: J1.1, J5.1+, K1.24, R1.2
unnamed: J1.2, J5.1-, K1.21
unnamed: J4.2, K1.11
unnamed: Q1.1 (C), R8.1
unnamed: Q1.3 (E), R9.2
unnamed: Q2.2 (B), R7.1, R8.2
unnamed: C2.1, Q2.1 (C), R4.1, R7.2
unnamed: R3.2, RV1.1
