FordPrfkt/KT88-Amp/Boards/Netzteil/400V_Anoden/400VAnoden.kicad_pcb

## KiCad design Boards/Netzteil/400V_Anoden/400VAnoden.kicad_pcb (2024-11-20)

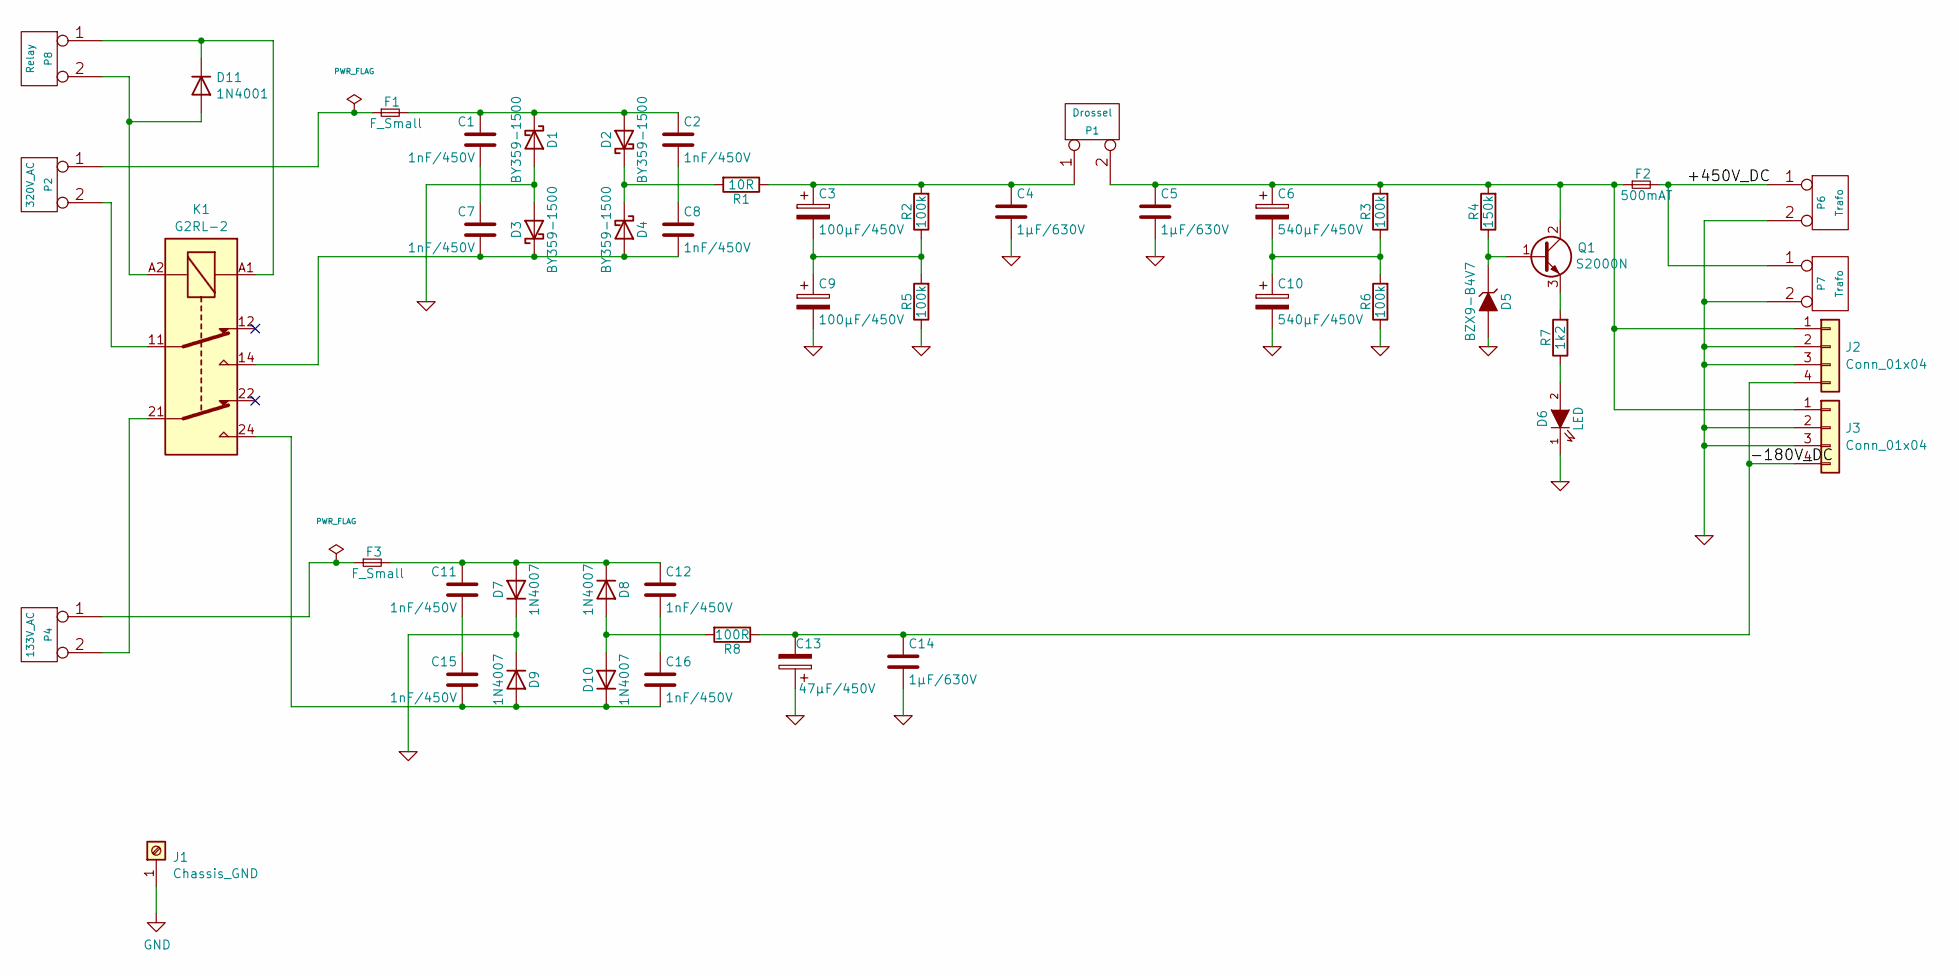
[picture p23: schematic 400VAnoden.kicad_sch]

Parts:
C1, C2, C7, C8, C11, C12, C15, C16: 1nF/450V; C_Rect_L10.0mm_W4.0mm_P7.50mm_FKS3_FKP3
C3, C9: 100µF/450V; CP_Radial_D22.0mm_P10.00mm_SnapIn
C4, C5, C14: 1µF/630V; C_Rect_L31.5mm_W11.0mm_P27.50mm_MKS4
C6, C10: 540µF/450V; CP_Radial_D35.0mm_P10.00mm_SnapIn
C13: 47µF/450V; CP_Radial_D16.0mm_P7.50mm
D1, D2, D3, D4: BY359-1500; TO-220-2_Vertical
D5: BZX9-B4V7; D_DO-35_SOD27_P10.16mm_Horizontal
D6: LED; LED_D5.0mm
D7, D8, D9, D10: 1N4007; D_DO-41_SOD81_P10.16mm_Horizontal
D11: 1N4001; D_DO-41_SOD81_P10.16mm_Horizontal
F1, F3: F_Small; Fuse__Holder_Eska_509100
F2: 500mAT; Fuse__Holder_Eska_509100
J1: Chassis_GND; MountingHole_3.2mm_M3_Pad_Via
J2, J3: Conn_01x04; Molex_Mini-Fit_Jr_5566-04A_2x02_P4.20mm_Vertical
K1: G2RL-2; Relay_DPDT_Omron_G2RL-2
P1: Drossel; Molex_Mini-Fit_Jr_5566-02A_2x01_P4.20mm_Vertical
P2: 320V_AC; Molex_Mini-Fit_Jr_5566-02A_2x01_P4.20mm_Vertical
P4: 133V_AC; Molex_Mini-Fit_Jr_5566-02A_2x01_P4.20mm_Vertical
P6, P7: Trafo; Molex_Mini-Fit_Jr_5566-02A_2x01_P4.20mm_Vertical
P8: Relay; Molex_KK-254_AE-6410-02A_1x02_P2.54mm_Vertical
Q1: S2000N; TO-3P-3_Horizontal_TabDown
R1: 10R; R_Axial_DIN0207_L6.3mm_D2.5mm_P10.16mm_Horizontal
R2, R3, R5, R6: 100k; R_Axial_DIN0207_L6.3mm_D2.5mm_P10.16mm_Horizontal
R4: 150k; R_Axial_DIN0207_L6.3mm_D2.5mm_P10.16mm_Horizontal
R7: 1k2; R_Axial_DIN0414_L11.9mm_D4.5mm_P15.24mm_Horizontal
R8: 100R; R_Axial_DIN0207_L6.3mm_D2.5mm_P10.16mm_Horizontal

Connections:
/+450V_DC: F2.2, P6.1, P7.1
/-180V_DC: C13.2, C14.1, J2.4, J3.4, R8.1
GND: C4.2, C5.2, C9.2, C10.2, C13.1, C14.2, D1.2 (A), D3.2 (A), D5.2 (A), D6.1 (K), D7.1 (K), D9.1 (K), J1.1, J2.2, J2.3, J3.2, J3.3, P6.2, P7.2, R5.1, R6.1
unnamed: C1.2, C7.1
unnamed: C2.2, C8.1
unnamed: C3.2, C9.1, R2.1, R5.2
unnamed: C6.2, C10.1, R3.1, R6.2
unnamed: C11.2, C15.1
unnamed: C12.2, C16.1
unnamed: C1.1, C2.1, D1.1 (K), D2.2 (A), F1.2
unnamed: D2.1 (K), D4.1 (K), R1.2
unnamed: C7.2, C8.2, D3.1 (K), D4.2 (A), K1.14
unnamed: D5.1 (K), Q1.1 (B), R4.1
unnamed: D6.2 (A), R7.1
unnamed: C11.1, C12.1, D7.2 (A), D8.1 (K), F3.2
unnamed: D8.2 (A), D10.2 (A), R8.2
unnamed: C15.2, C16.2, D9.2 (A), D10.1 (K), K1.24
unnamed: D11.2 (A), K1.A2, P8.2
unnamed: D11.1 (K), K1.A1, P8.1
unnamed: C5.1, C6.1, F2.1, J2.1, J3.1, P1.2, Q1.2 (C), R3.2, R4.2
unnamed: C3.1, C4.1, P1.1, R1.1, R2.2
unnamed: F1.1, P2.1
unnamed: K1.11, P2.2
unnamed: F3.1, P4.1
unnamed: K1.21, P4.2
unnamed: Q1.3 (E), R7.2

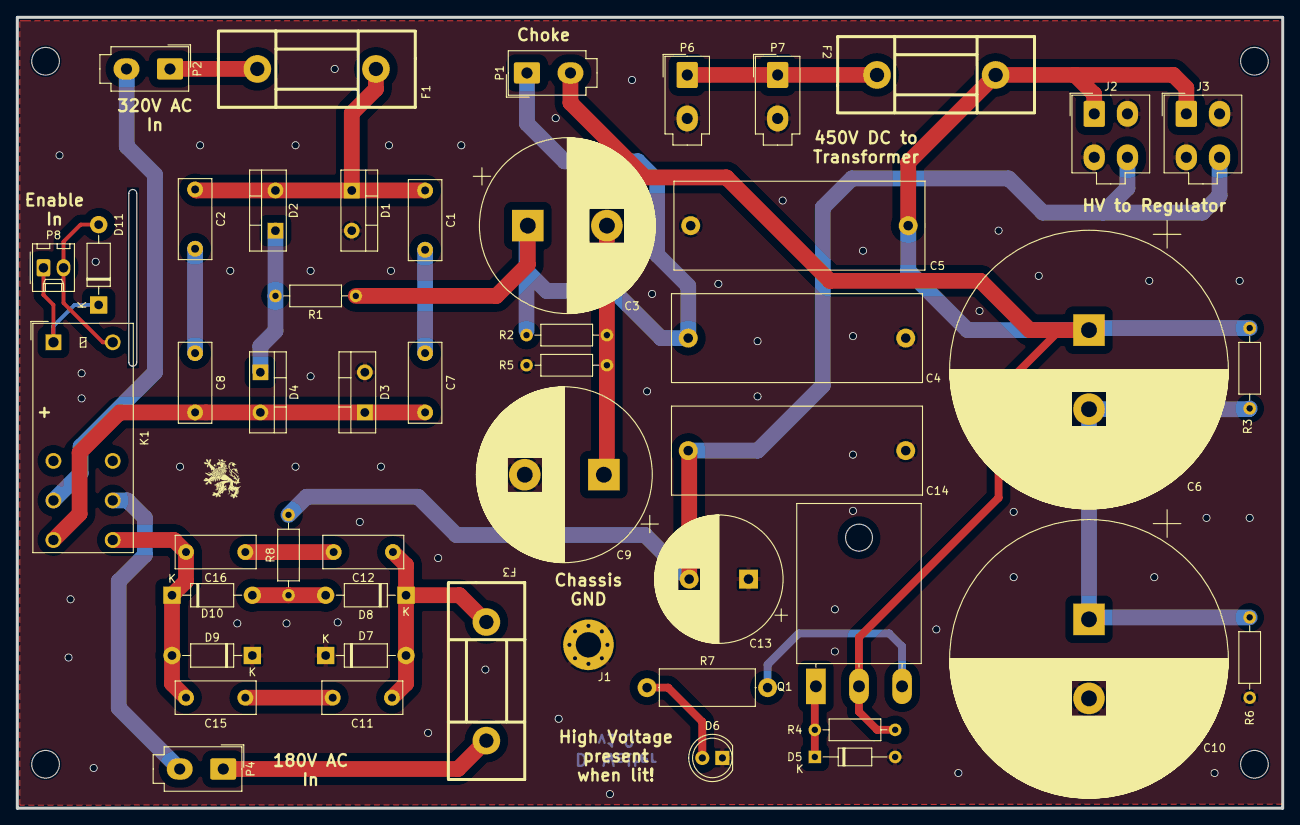
[picture p24: board 400VAnoden.kicad_pcb from above]

Board: 2 copper layers, 160.0 x 100.0 mm, 49 parts (0 on the bottom side), 26 nets.
