FordPrfkt/KT88-Amp/boards/Netzteil/12V_6V3_Delay/12V_6V3_Delay.kicad_pcb

## KiCad design boards/Netzteil/12V_6V3_Delay/12V_6V3_Delay.kicad_pcb (2024-11-20)

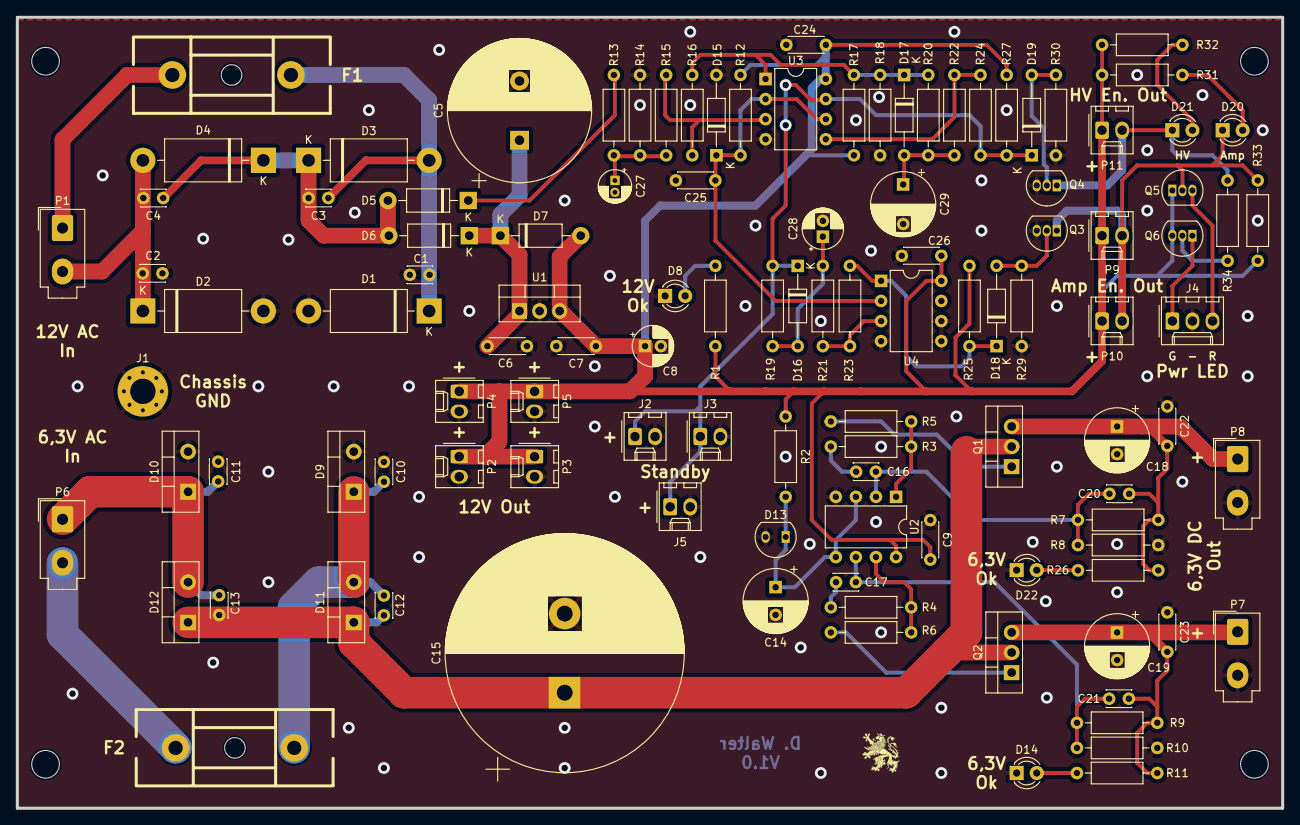
[picture p25: board 12V_6V3_Delay.kicad_pcb from above]

Board: 2 copper layers, 160.0 x 100.0 mm, 112 parts (0 on the bottom side), 45 nets.

Parts:
C1, C2, C3, C4, C10, C11, C12, C13: 22nF; C_Disc_D3.0mm_W2.0mm_P2.50mm
C5: 4700µF / 63V; CP_Radial_D18.0mm_P7.50mm
C6, C24, C25, C26: 100nF / 63V; C_Disc_D4.3mm_W1.9mm_P5.00mm
C7: Fuse; C_Disc_D4.3mm_W1.9mm_P5.00mm
C8: 47µF / 16V; CP_Radial_D5.0mm_P2.00mm
C9, C22, C23: 100nF; C_Disc_D4.3mm_W1.9mm_P5.00mm
C14: 680µF/16V; CP_Radial_D8.0mm_P3.50mm
C15: 33000µF/16V; CP_Radial_D30.0mm_P10.00mm_SnapIn
C16, C17, C20, C21: 1nF; C_Disc_D3.0mm_W2.0mm_P2.50mm
C18, C19: 680µF; CP_Radial_D8.0mm_P3.50mm
C27: 1µF / 16V; CP_Radial_D4.0mm_P1.50mm
C28: 10µF / 16V; CP_Radial_D5.0mm_P2.00mm
C29: 330µF / 16V; CP_Radial_D8.0mm_P5.00mm
D1, D2, D3, D4: SB350; D_DO-201AD_P15.24mm_Horizontal
D5: SB190; D_DO-41_SOD81_P10.16mm_Horizontal
D6: SB350; D_DO-41_SOD81_P10.16mm_Horizontal
D7: 1N4001; D_DO-41_SOD81_P10.16mm_Horizontal
D8, D14, D20, D21, D22: LED; LED_D3.0mm
D9, D10, D11, D12: MBR1645; TO-220-2_Vertical
D13: LM385Z-1.2; TO-92-2
D15: ZD3V9; D_DO-35_SOD27_P10.16mm_Horizontal
D16, D17: 1N4148; D_DO-35_SOD27_P10.16mm_Horizontal
D18, D19: ZD5V6; D_DO-35_SOD27_P10.16mm_Horizontal
F1, F2: Fuse; Fuse_Holder_Eska_509200
J1: Chassis_GND; MountingHole_3.2mm_M3_Pad_Via
J2, J3, J5: Standby; Molex_KK-254_AE-6410-02A_1x02_P2.54mm_Vertical
J4: Conn_01x03; Molex_KK-254_AE-6410-03A_1x03_P2.54mm_Vertical
P1: 12V5_AC; Molex_Mini-Fit_Jr_5566-02A_2x01_P4.20mm_Vertical
P2: 12V_DC_1; Molex_KK-254_AE-6410-02A_1x02_P2.54mm_Vertical
P3: 12V_DC_2; Molex_KK-254_AE-6410-02A_1x02_P2.54mm_Vertical
P4: 12V_DC_3; Molex_KK-254_AE-6410-02A_1x02_P2.54mm_Vertical
P5: 12V_DC_4; Molex_KK-254_AE-6410-02A_1x02_P2.54mm_Vertical
P6: 7V5_AC; Molex_Mini-Fit_Jr_5566-02A_2x01_P4.20mm_Vertical
P7: 6V3_DC_2; Molex_Mini-Fit_Jr_5566-02A_2x01_P4.20mm_Vertical
P8: 6V3_DC_1; Molex_Mini-Fit_Jr_5566-02A_2x01_P4.20mm_Vertical
P9, P10, P11: Relais; Molex_KK-254_AE-6410-02A_1x02_P2.54mm_Vertical
Q1, Q2: IRF530; TO-220-3_Vertical
Q3, Q4: BS170; TO-92_Inline
Q5: BC337; TO-92_Inline
Q6: BC557; TO-92_Inline
R1, R31: 560R; R_Axial_DIN0207_L6.3mm_D2.5mm_P10.16mm_Horizontal
R2: 22k; R_Axial_DIN0207_L6.3mm_D2.5mm_P10.16mm_Horizontal
R3, R4: 100R; R_Axial_DIN0207_L6.3mm_D2.5mm_P10.16mm_Horizontal
R5, R6, R8, R10: 1k; R_Axial_DIN0207_L6.3mm_D2.5mm_P10.16mm_Horizontal
R7, R9: 4k12; R_Axial_DIN0207_L6.3mm_D2.5mm_P10.16mm_Horizontal
R11, R26: 270R; R_Axial_DIN0207_L6.3mm_D2.5mm_P10.16mm_Horizontal
R12: 4K7; R_Axial_DIN0207_L6.3mm_D2.5mm_P10.16mm_Horizontal
R13: 82K; R_Axial_DIN0207_L6.3mm_D2.5mm_P10.16mm_Horizontal
R14, R29, R30: 100K; R_Axial_DIN0207_L6.3mm_D2.5mm_P10.16mm_Horizontal
R15, R17, R18, R21, R22, R25, R27: 10K; R_Axial_DIN0207_L6.3mm_D2.5mm_P10.16mm_Horizontal
R16: 1M; R_Axial_DIN0207_L6.3mm_D2.5mm_P10.16mm_Horizontal
R19: 330K; R_Axial_DIN0207_L6.3mm_D2.5mm_P10.16mm_Horizontal
R20: 220K; R_Axial_DIN0207_L6.3mm_D2.5mm_P10.16mm_Horizontal
R23, R24: 5M1; R_Axial_DIN0207_L6.3mm_D2.5mm_P10.16mm_Horizontal
R32: 560; R_Axial_DIN0207_L6.3mm_D2.5mm_P10.16mm_Horizontal
R33, R34: 4k7; R_Axial_DIN0207_L6.3mm_D2.5mm_P10.16mm_Horizontal
U1: LM7812CT; TO-220-3_Vertical
U2: LMC6482; DIP-8_W7.62mm
U3, U4: LM393; DIP-8_W7.62mm

Connections:
12V_Rect: D5.1 (K), R13.1
+12V: C7.1, C8.1, C9.2, C24.1, C26.1, D7.2 (A), P2.1, P3.1, P4.1, P5.1, P9.1, P10.1, P11.1, Q5.1 (C), Q6.3 (E), R1.1, R2.2, R12.1, R17.2, R25.1, R27.1, R31.1, R32.1, R33.2, U1.3 (OUT), U2.8 (V+), U3.8 (V+), U4.8 (V+)
/6V3/Reference: C14.1, D13.1 (K), R2.1, U2.3 (+), U2.5 (+)
/6V3/V_Unreg: C12.2, C13.1, C15.1, D11.1 (K), D12.1 (K), Q1.2 (D), Q2.2 (D)
/Delay/LED_G: J4.1, Q6.1 (C)
/Delay/LED_R: J4.3, Q5.3 (E)
/Delay/Vref: C25.1, D15.1 (K), R12.2, U3.2 (-), U3.6 (_), U4.2 (-)
GND: C1.2, C2.1, C5.2, C6.2, C7.2, C8.2, C9.1, C10.2, C11.1, C14.2, C15.2, C18.2, C19.2, C22.1, C23.1, C24.2, C25.2, C26.2, C27.2, C28.2, C29.2, D1.2 (A), D2.2 (A), D8.1 (K), D9.2 (A), D10.2 (A), D13.2 (A), D14.1 (K), D15.2 (A), D22.1 (K), J1.1, J2.2, J3.2, J4.2, J5.2, P2.2, P3.2, P4.2, P5.2, P7.2, P8.2, Q3.3 (S), Q4.3 (S), R8.1, R10.1, R14.2, R18.1, R29.2, R30.2, U1.2 (GND), U2.4 (V-), U3.4 (V-), U4.4 (V-), U4.5 (+), U4.6 (_)
unnamed: C16.1, R3.1
unnamed: C17.1, R4.1
unnamed: C27.1, R13.2, R14.1, R15.2
unnamed: C1.1, C3.1, D1.1 (K), D3.2 (A), F1.2
unnamed: C2.2, C4.2, D2.1 (K), D4.2 (A), P1.2
unnamed: C3.2, C4.1, D3.1 (K), D4.1 (K), D5.2 (A), D6.2 (A)
unnamed: C5.1, C6.1, D6.1 (K), D7.1 (K), U1.1 (IN)
unnamed: D8.2 (A), R1.2
unnamed: C11.2, C13.2, D10.1 (K), D12.2 (A), P6.1
unnamed: C10.1, C12.1, D9.1 (K), D11.2 (A), F2.1
unnamed: D14.2 (A), R11.2
unnamed: C28.1, D16.2 (A), R19.2, R21.1
unnamed: D16.1 (K), D19.1 (K), J2.1, J3.1, J5.1, R19.1, R24.2, R27.2, U3.7
unnamed: C29.1, D17.2 (A), R20.2, R22.1
unnamed: D17.1 (K), R16.1, R17.1, R18.2, R20.1, U3.1
unnamed: D18.2 (A), Q3.2 (G), R29.1
unnamed: D18.1 (K), R23.2, R25.2, U4.1
unnamed: D19.2 (A), Q4.2 (G), R30.1
unnamed: D20.2 (A), R31.2
unnamed: D20.1 (K), P9.2, P10.2, Q3.1 (D), Q5.2 (B), R33.1
unnamed: D21.2 (A), R32.2
unnamed: D21.1 (K), P11.2, Q4.1 (D), R34.2
unnamed: D22.2 (A), R26.2
unnamed: F1.1, P1.1
unnamed: F2.2, P6.2
unnamed: C19.1, C21.2, C23.2, P7.1, Q2.3 (S), R9.2, R11.1
unnamed: C18.1, C20.2, C22.2, P8.1, Q1.3 (S), R7.2, R26.1
unnamed: Q1.1 (G), R5.1
unnamed: Q2.1 (G), R6.1
unnamed: Q6.2 (B), R34.1
unnamed: R3.2, R5.2, U2.1
unnamed: R4.2, R6.2, U2.7
unnamed: C16.2, C20.1, R7.1, R8.2, U2.2 (-)
unnamed: C17.2, C21.1, R9.1, R10.2, U2.6 (-)
unnamed: R15.1, R16.2, U3.3 (+)
unnamed: R22.2, R24.1, U3.5 (+)
unnamed: R21.2, R23.1, U4.3 (+)
