FordPrfkt/KT88-Amp/boards/Aussteuerung/Aussteuerung.kicad_pcb

## KiCad design boards/Aussteuerung/Aussteuerung.kicad_pcb (2024-11-20)

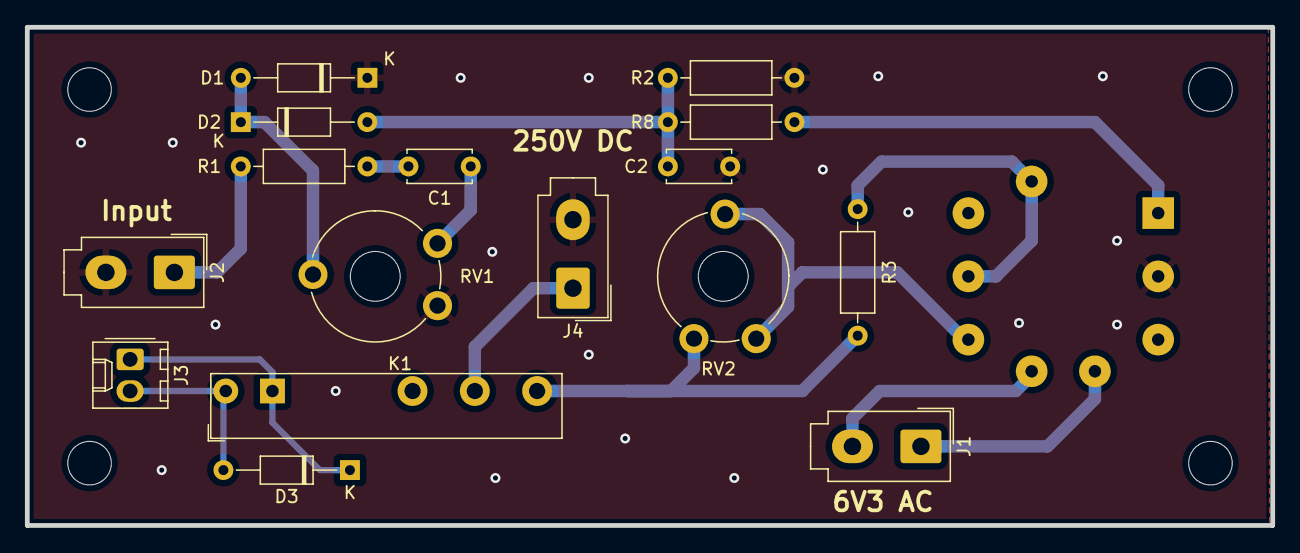
[picture p26: board Aussteuerung.kicad_pcb from above]

Board: 2 copper layers, 100.0 x 40.0 mm, 17 parts (1 on the bottom side), 15 nets.

Parts:
C1: 100nF / 500V; C_Disc_D5.0mm_W2.5mm_P5.00mm
C2: 220nF; C_Disc_D5.0mm_W2.5mm_P5.00mm
D1, D2: 1N4007; D_DO-35_SOD27_P10.16mm_Horizontal
D3: D; D_DO-35_SOD27_P10.16mm_Horizontal
J1: 6V3_Heater; Molex_Mini-Fit_Jr_5566-02A_2x01_P4.20mm_Vertical
J2: Signal_R; Molex_Mini-Fit_Jr_5566-02A_2x01_P4.20mm_Vertical
J3: Signal_R; Molex_KK-254_AE-6410-02A_1x02_P2.54mm_Vertical
J4: 250VDC; Molex_Mini-Fit_Jr_5566-02A_2x01_P4.20mm_Vertical
K1: FINDER-34.51; Relay_SPDT_Finder_34.51_Vertical
R1: 100k; R_Axial_DIN0207_L6.3mm_D2.5mm_P10.16mm_Horizontal
R2, R8: 1M; R_Axial_DIN0207_L6.3mm_D2.5mm_P10.16mm_Horizontal
R3: 470k; R_Axial_DIN0207_L6.3mm_D2.5mm_P10.16mm_Horizontal
RV1: 220k; Potentiometer_Piher_PT-10-V10_Vertical_Hole
RV2: 47k; Potentiometer_Piher_PT-10-V10_Vertical_Hole
U1: EM84; Valve_Noval_P

Connections:
GND: C2.2, D1.1, J2.2, J4.2, R2.2, RV1.3, U1.2
unnamed: C1.1, R1.2
unnamed: C1.2, RV1.1
unnamed: C2.1, D2.2, R2.1, R8.1
unnamed: D1.2, D2.1, RV1.2
unnamed: D3.1, J3.1, K1.A1
unnamed: D3.2, J3.2, K1.A2
unnamed: J1.1, U1.4
unnamed: J1.2, U1.5
unnamed: J2.1, R1.1
unnamed: J4.1, K1.11
unnamed: K1.14, R3.1, RV2.3
unnamed: R3.2, U1.7, U1.9
unnamed: R8.2, U1.1
unnamed: RV2.1, RV2.2, U1.6
