FordPrfkt/KT88-Amp/boards/Netzteil/6V3_AC_Distribution/6V3_AC_Distribution.kicad_pcb

## KiCad design boards/Netzteil/6V3_AC_Distribution/6V3_AC_Distribution.kicad_pcb (2024-11-20)

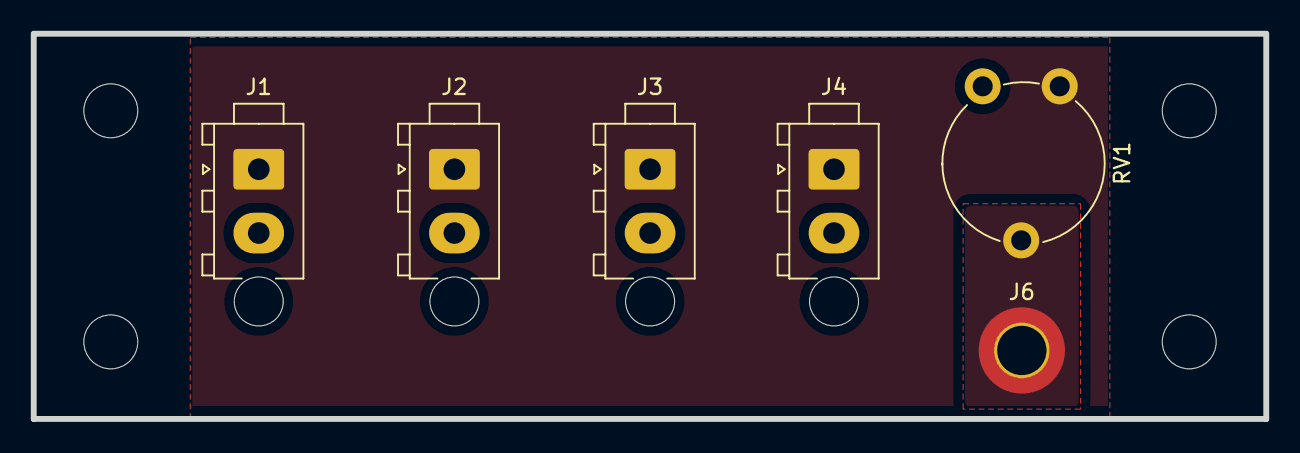
[picture p27: board 6V3_AC_Distribution.kicad_pcb from above]

Board: 2 copper layers, 80.0 x 25.0 mm, 6 parts (0 on the bottom side), 3 nets, no tracks yet.

Parts:
J1, J2, J3, J4: Conn_01x02; TE_MATE-N-LOK_1-770866-x_1x02_P4.14mm_Vertical
J6: Screw_Terminal_01x01; MountingHole_3.2mm_M3_DIN965_Pad_TopOnly
RV1: R_POT; Potentiometer_Piher_PT-10-V10_Vertical

Connections:
GND: J6.1, RV1.2
unnamed: J1.1, J2.1, J3.1, J4.1, RV1.3
unnamed: J1.2, J2.2, J3.2, J4.2, RV1.1
