FordPrfkt/KT88-Amp/boards/ReglerV2/Regler.kicad_pcb

## KiCad design boards/ReglerV2/Regler.kicad_pcb (2023-09-05)

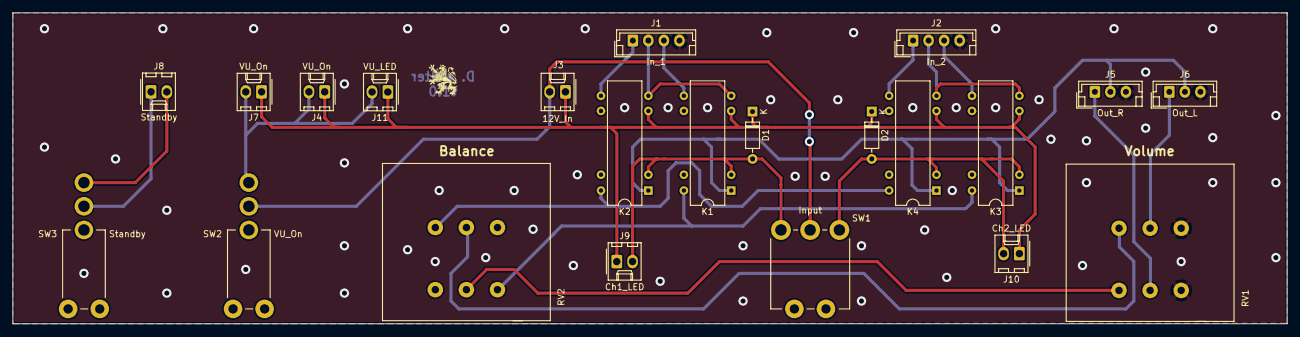
[picture p28: board Regler.kicad_pcb from above]

Board: 2 copper layers, 205.0 x 50.0 mm, 22 parts (0 on the bottom side), 21 nets.

Parts:
D1, D2: 1N4148; D_DO-35_SOD27_P7.62mm_Horizontal
J1: In_1; JST_EH_B4B-EH-A_1x04_P2.50mm_Vertical
J2: In_2; JST_EH_B4B-EH-A_1x04_P2.50mm_Vertical
J3: 12V_In; Molex_KK-254_AE-6410-02A_1x02_P2.54mm_Vertical
J4, J7: VU_On; Molex_KK-254_AE-6410-02A_1x02_P2.54mm_Vertical
J5: Out_R; JST_EH_B3B-EH-A_1x03_P2.50mm_Vertical
J6: Out_L; JST_EH_B3B-EH-A_1x03_P2.50mm_Vertical
J8: Standby; Molex_KK-254_AE-6410-02A_1x02_P2.54mm_Vertical
J9: Ch1_LED; Molex_KK-254_AE-6410-02A_1x02_P2.54mm_Vertical
J10: Ch2_LED; Molex_KK-254_AE-6410-02A_1x02_P2.54mm_Vertical
J11: VU_LED; Molex_KK-254_AE-6410-02A_1x02_P2.54mm_Vertical
K1, K2, K3, K4: DIPxx-2Axx-21x; Relay_StandexMeder_DIP_LowProfile
RV1: Alps 20k log; Potentiometer_Alps-RK271-double
RV2: Alps 50k lin; Potentiometer_Alps-RK271-double
SW1: Input; 7101MD9ABE
SW2: VU_On; 7101MD9AV2BE
SW3: Standby; 7101MD9AV2BE

Connections:
+12V: D1.1 (K), D2.1 (K), J3.1, J4.1, J7.1, J9.1, J10.1, J11.1, K1.6, K2.6, K3.6, K4.6
/CH_1: D1.2 (A), J9.2, K1.2, K2.2, SW1.3 (C)
/CH_2: D2.2 (A), J10.2, K3.2, K4.2, SW1.1 (A)
/GND_1: J1.2, K1.7, K2.7
/GND_2: J2.2, K3.7, K4.7
/L_1: J1.1, K2.8
/L_2: J2.1, K4.8
/L_Out: J6.1, RV1.5
/L_Sw: K2.14, K4.14, RV2.4
/R_1: J1.3, K1.8
/R_2: J2.3, K3.8
/R_Out: J5.1, RV1.2
/R_Sw: K1.14, K3.14, RV2.3
Earth_Clean: J1.4, J2.4, J5.3, J6.3, RV1.3, RV1.6
GND: J3.2, SW1.2 (B), SW2.2 (B)
GNDS: J5.2, J6.2, K1.1, K2.1, K3.1, K4.1
unnamed: J8.1, SW3.2 (B)
unnamed: J8.2, SW3.3 (C)
unnamed: J4.2, J7.2, J11.2, SW2.3 (C)
unnamed: RV1.1, RV2.2
unnamed: RV1.4, RV2.5
