FordPrfkt/KT88-Amp/(commit log)

2016-02-11 Anoden-Stabi auf eigenes Board, Endstufe Layouttest
    [400VAnoden.kicad_pcb, Anoden_Stabi.kicad_pcb, Anoden_Stabi.sch, Eingang.kicad_pcb, Eingang.sch, Endstufe.kicad_pcb, Endstufe.sch, Regler.kicad_pcb]
2016-05-03 Updated Layout
    [12V_Supply.kicad_pcb, 400VAnoden.kicad_pcb, 6V3_Heizung.kicad_pcb, 6V3_Heizung.sch, Anoden_Stabi.kicad_pcb, Endstufe.kicad_pcb, Endstufe.sch]
2016-08-27 Work in Progress
    [12V_Supply.kicad_pcb, 12V_Supply.sch, 400VAnoden.kicad_pcb, 400VAnoden.sch, 6V3_Heizung.kicad_pcb, 6V3_Heizung.sch, Anoden_Stabi.kicad_pcb, Anoden_Stabi.sch]
2016-10-06 Bias-Anzeige erstellt
    [Bias.kicad_pcb, Bias.sch, Endstufe.kicad_pcb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]
2016-10-08 New Layout of Bias Board
    [Bias.kicad_pcb]
2016-10-08 New Potis
    [Regler.kicad_pcb, Regler.sch]
2019-04-22 Converted to Kicad 5.1 and Layout changes
    [12V_Supply.kicad_pcb, 12V_Supply.sch, 12V_Supply_V2.kicad_pcb, 12V_Supply_V2.sch, 400VAnoden.kicad_pcb, 400VAnoden.sch, 6V3_Heizung.kicad_pcb, 6V3_Heizung.sch]
2019-04-24 Layout changes after migrate to Kicad 5.1
    [12V_Supply_V2.kicad_pcb, Bias.kicad_pcb, Bias.sch, Eingang.kicad_pcb, Eingang.sch, Endstufe.kicad_pcb, Endstufe.sch, Regler.sch]
2019-09-23 Minor Layout changes
    [400VAnoden.kicad_pcb, 6V3_Heizung.kicad_pcb, Endstufe.kicad_pcb, Regler.kicad_pcb]
2019-10-21 Layout changes, Supply connector changes, Mounting holes
    [400VAnoden.kicad_pcb, 400VAnoden.sch, 6V3_Heizung.kicad_pcb, 6V3_Heizung.sch, Anoden_Stabi.kicad_pcb, Anoden_Stabi.sch, Endstufe.kicad_pcb, Endstufe.sch]
2019-11-13 HV Switch on delay added
    [12V_Supply_V2.kicad_pcb, 400VAnoden.kicad_pcb, 400VAnoden.sch, 6V3_Heizung.kicad_pcb, 6V3_Heizung.sch, Bias.kicad_pcb, Stromverteiler.kicad_pcb, Stromverteiler.sch]
2019-11-23 Added Vias & Mounting Holes
    [12V_Supply_V2.kicad_pcb, 400VAnoden.kicad_pcb, 6V3_Heizung.kicad_pcb, Anoden_Stabi.kicad_pcb, Bias.kicad_pcb, Endstufe.kicad_pcb]
2019-11-29 Added Test, moved mounting holes
    [12V_Supply_V2.kicad_pcb, 400VAnoden.kicad_pcb, 6V3_Heizung.kicad_pcb, Anoden_Stabi.kicad_pcb, Endstufe.kicad_pcb, Regler.kicad_pcb]
2019-12-05 New Volume Control Board
    [12V_Supply_V2.kicad_pcb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]
2019-12-15 Added Power LEDs
    [12V_Supply_V2.kicad_pcb, 12V_Supply_V2.sch, 400VAnoden.kicad_pcb, 6V3_Heizung.kicad_pcb, 6V3_Heizung.sch, Regler.kicad_pcb]
2020-01-27 Adjusted Silkscreen
    [12V_Supply_V2.kicad_pcb, 400VAnoden.kicad_pcb, 6V3_Heizung.kicad_pcb, Anoden_Stabi.kicad_pcb, Bias.kicad_pcb, Endstufe.kicad_pcb, Endstufe.sch, Regler.kicad_pcb]
2021-02-27 Added Mounting holes, Moved -60V Divider to HV Board, eliminated +450V Connector and Feedback Connector on Amp Board
    [12V_Supply_V2.kicad_pcb, 12V_Supply_V2.sch, 400VAnoden.kicad_pcb, 6V3_Heizung.kicad_pcb, 6V3_Heizung.step, Anoden_Stabi.kicad_pcb, Anoden_Stabi.sch, Bias.kicad_pcb]
2021-04-20 6,3V und 12V auf einer Platine zusammengefasst
    [12V.sch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]
2021-05-21 Reworked Delay + Layout changed
    [12V.sch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]
2021-11-07 Work in progess - many LAyour changes
    [12V.sch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]
2024-11-20 6.3V, 400V und 400V Regler Boards bestellt
    [12V.kicad_sch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]
2025-02-26 Leiterplatten erstellt
    [Aussteuerung.kicad_sch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]
2025-02-26 Leiterplatte erstellt
    [Bias.kicad_pcb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]
